paul-jo-dreyer/Atom/README.md

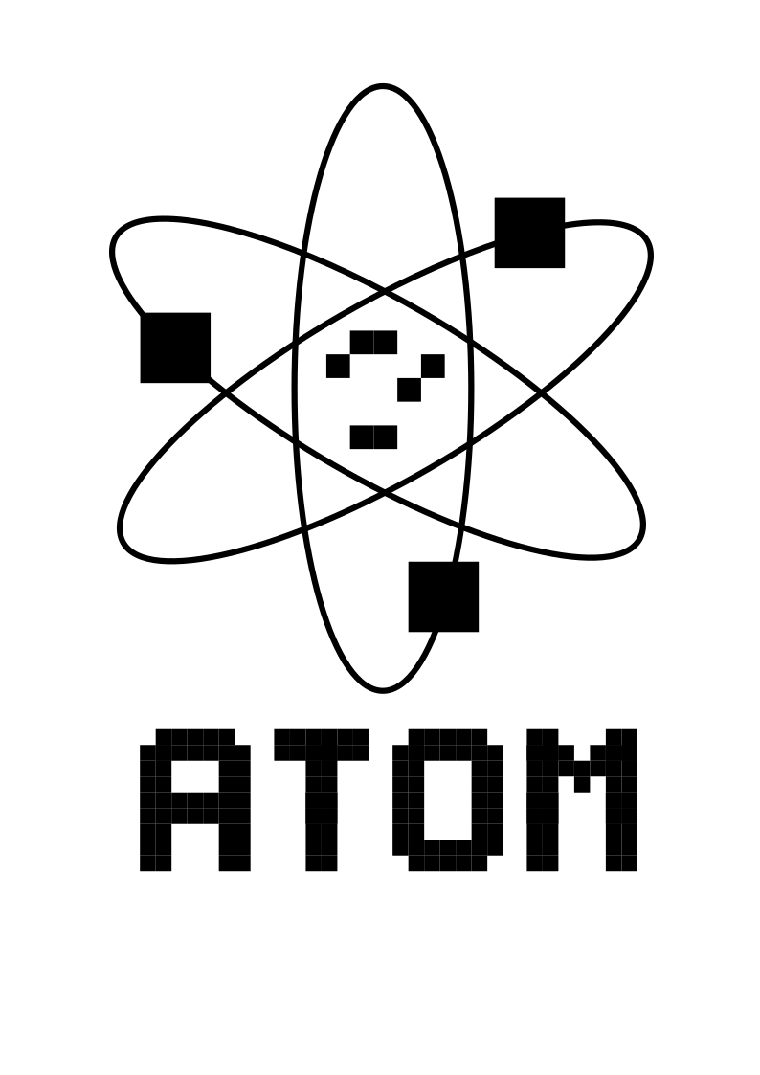
[picture p1: assets/ATOM.png]


# The Atom Project Overview

Atom is a micro modular robot designed as a test platform for studying swarm robotics, including multi-agent planning, control, and coordination. Up to 10 Atom robots can be in play at a given time, acting independently, or collaboratively. Paired with an **overwatch** application, state update information is streamed to each of the robots in a group broadcast, enabling rapid, low cost localization of each bot within the environment. 

## Communications

Each Atom is connected to a local Wifi network. 

## Localization

Localization of the system is handled by an overwatch system, which identifies Apriltags attached to the compute-chunk of each robot, and to the base station.

# Case Studies

## 1v1 Soccer
