paul-jo-dreyer/Atom/AtomSim/vehicle_dynamics/diff_drive/analysis/diff_drive.pdf

## diff drive dynamics: derivation and analysis

Atom project

April 26, 2026

Abstract

This document derives the planar dynamics of a two-wheeled differential-drive vehicle, start-ing from the rolling-without-slipping wheel constraints and ending at the analytic Jacobians used by the linearisation. It is the canonical reference for the C++ implementation in
bl bla blaaa ssss dynamics/diff drive/core/ and the numerical companion notebook in analysis/dynamics tour.ipynb.

## Contents

1 Setup and notation | 2
2 Wheel-contact constraints | 3
3 Kinematics: wheel speeds and body twist | 4
4 Dynamics: motor lag and the state ODE | 6

5 Linearisation about an operating point | 7
6 Verification | 9

## 1 Setup and notation

### 1.1 Frames

We work entirely in the plane. The world frame is inertial with axes (ˆxw, yŵ). The body frame is rigidly attached to the vehicle at the geometric centre of the wheel axle, with ˆxb pointing forward (the direction of travel when both wheels rotate equally) and ŷb pointing to the left:

xˆb =

cos θ
sin θ
, yˆb =
− sin θ
cos θ
. | (1)

### 1.2 Configuration and velocities

The configuration is
q = (px, py, θ) ∈ R

2 × S

1
, | (2)

where (px, py) is the world-frame position of the wheel-axle midpoint and θ is the heading. We use the body twist (v, ω) as the dynamical coordinates for translational and angular velocity:

v = ṗx cos θ + ṗy sin θ, | (3)
ω = ˙θ. | (4)

Once the no-side-slip constraint of §2 is imposed, this reduces to ( ṗx, pẏ) = v xˆb.

### 1.3 Geometric and actuator parameters

Track width W — distance between the left and right wheel contacts. Default 0.2 m.

Wheel radius rw — used only when converting between commanded wheel angular velocity ϕ˙ and rim velocity vw = rw ϕ˙

Motor time constant τ — first-order lag from commanded to realised body velocities. Default 0.05 s.

### 1.4 Wheel inputs

The control input is the pair of commanded wheel rim velocities u = (vL, vR), with vL = rw ϕ˙
L
and similarly for the right wheel. We use vL, vR rather than ϕ˙

L, ϕṘ throughout because the wheel radius is absorbed at the controller boundary and never appears in the body dynamics. The Control<Scalar> type in types.hpp stores exactly this pair.

## 2 Wheel-contact constraints

The vehicle has two wheels, each treated as an ideal rigid disk rolling without slipping on a planar ground. Each contact point yields two scalar constraints — one along the rolling direction and one perpendicular to it. Below we derive both, show that the lateral pair degenerates into a single body-level constraint, and prove that this constraint is non-holonomic.

### 2.1 Wheel positions and contact velocities

The left wheel sits a distance W/2 along ŷb from the body origin; the right wheel sits the same distance along −yˆb:

rL =

px −

1
2W sin θ
py +

1
2W cos θ
, | rR =
px +

1
2W sin θ
py −

1
2W cos θ
. | (5)

Differentiating in time,

r˙L =

pẋ −

1

2W ˙θ cos θ
pẏ −

1

2W ˙θ sin θ

, | rṘ =
pẋ +

1

2W ˙θ cos θ

pẏ +

1

2W ˙θ sin θ

. | (6)

### 2.2 Lateral constraint (no side slip)

Each wheel cannot move along its axle. Both axles are aligned with ŷb, so for each wheel the constraint is ṙw · yˆb = 0:

r˙L · yˆb = −pẋ sin θ +

1

2W ˙θ cos θ sin θ + ṗy cos θ −
1

2W ˙θ sin θ cos θ

= −pẋ sin θ + ṗy cos θ. | | (7)

The ˙θ-dependent cross terms cancel because the wheel offset is itself along ŷb, so the spin-induced contact velocity is along ˆxb, not ŷb. The right wheel gives the same expression. Both lateral constraints therefore collapse into a single body-level Pfaffian constraint:

| − sin θ pẋ + cos θ pẏ = 0. | (8)

### 2.3 Longitudinal constraint (pure rolling)

The forward velocity of each wheel contact equals its rim velocity:

r˙L · xˆb = vL, | rṘ · xˆb = vR. | (9)

Expanding,

vL = ṗx cos θ + ṗy sin θ −

1

| 2W ˙θ = v −
| 1
| 2W ω, | (10)

vR = ṗx cos θ + ṗy sin θ +

1

| 2W ˙θ = v +
| 1
| 2W ω. | (11)

Solving for the body twist,

v =

1/2(vL + vR), | ω =
| vR − vL
| W
| . | (12)

This is the map used at the top of DiffDriveDynamics::continuous in core/dynamics.hpp.

### 2.4 Pfaffian form

Stacking the three constraints,

− sin θ cos θ 0
cos θ sin θ −

1
2W
cos θ sin θ +

1
2W
| | {z | }
| A(q)

pẋ
pẏ
˙θ
- =

0
vL
vR
- . | (13)

Row 1 is homogeneous in ˙q — no actuator drives it. This is the non-holonomic part. Rows 2–3 are inhomogeneous, driven by the wheel commands.

### 2.5 The constraint is non-holonomic

A Pfaffian constraint a(q) · q˙ = 0 is integrable to a function h(q) = const if and only if the dual distribution ∆ = ker a(q) is involutive (Frobenius theorem). For (8),

∆ = span{X1, X2}, X1 =

cos θ
sin θ
0
- , X2 =

0
0
1
- , | (14)

where X1 generates pure forward motion and X2 generates pure rotation in place. The Lie bracket is
[X1, X2] = ∂X1
∂q X2 −

∂X2
∂q X1 =

− sin θ
cos θ
0
- − 0. | (15)

This vector is precisely the body-lateral direction (8) forbids, so [X1, X2] ∈/ ∆. The distribution is therefore non-involutive, (8) is non-integrable, and the system is non-holonomic. □

Remark (Chow’s theorem and parking). The set {X1, X2, [X1, X2]} spans R

3 at every q. By
Chow’s theorem the system is locally controllable: any configuration (px, py, θ) can be reached by combining forward motion and rotation, even though the vehicle has only two control inputs and cannot translate sideways instantaneously. Parallel parking is the everyday demonstration of this fact.

### 2.6 Consistency with the implementation

The state ODE in dynamics.hpp is written directly in body coordinates,

pẋ = v cos θ, | pẏ = v sin θ, | (16)

which substituted into (8) gives −v sin θ cos θ + v sin θ cos θ = 0 identically. The constraint is built into the parameterisation; the simulator does not need projection or Lagrange multipliers to enforce it at runtime. The numerical verification of this identity over a long rollout will live in analysis/dynamics tour.ipynb (a future “Test 5: constraint satisfaction” cell).

## 3 Kinematics: wheel speeds and body twist

The constraints in §2 relate wheel rim velocities (vL, vR) to body twist (v, ω) via (12). This section unpacks the consequences of that map: how to convert between actuator space and body space, the geometric picture, and the special operating modes that come up later.

### 3.1 Forward and inverse maps

The forward map (wheel commands → body twist), restated from (12),

v =

1/2(vL + vR), ω =

vR − vL
W
. | (17)

The inverse map (desired body twist → wheel commands) follows immediately from the rolling constraints in §2:
vL = v −

1
2W ω, vR = v +

1
2W ω. | (18)

Both maps are linear and invertible, so the kinematic state of the differential drive is captured equally well in either parameterisation. Internally the dynamics core in §4 carries (v, ω) as state and treats (vL, vR) as the boundary input, because the body twist is what couples to the motor lag and to Box2D.

### 3.2 Instantaneous centre of rotation

For any non-zero ω the body’s instantaneous motion is a rotation about a point fixed in the world frame at signed distance R along ŷb, where

R =

v
ω

=

W
2

·

vL + vR
vR − vL
. | (19)

This is the instantaneous centre of rotation (ICR). R is the signed turn radius: positive when turning left (CCW), negative when turning right.

### 3.3 Special operating modes

Pure forward. vL = vR =⇒ ω = 0, v = vL = vR. Straight-line motion; ICR at infinity.

Pure rotation. vL = −vR =⇒ v = 0, ω = 2vR/W. The vehicle spins about the body origin; ICR coincident with the axle midpoint.

One wheel locked. vL = 0 =⇒ v = vR/2, ω = vR/W, R = W/2. The vehicle pivots about the locked wheel; ICR at the locked wheel’s contact point.

These three modes form a useful test set — each isolates one component of (17) from the others, and Test 2 and Test 3 of dynamics tour.ipynb exercise the first two directly (§6).

### 3.4 The kinematic unicycle interpretation

Once the no-slip constraint (8) is imposed, the planar motion of the vehicle is entirely described by a unicycle on (px, py, θ) driven by the body twist (v, ω):

pẋ = v cos θ, | (20)
pẏ = v sin θ, | (21)
˙θ = ω. | (22)

The differential-drive structure shows up only in (i) how (v, ω) are produced by the wheels — equation (17) above — and (ii) the motor lag in §4 that separates commanded from realised body twist. Many planning algorithms operate at the unicycle level and only invert through (18) at the lowest control layer; we keep both layers explicit here because the motor lag couples them at the dynamics level.

## 4 Dynamics: motor lag and the state ODE

The kinematic map of §3 treats wheel commands as instantaneously producing the desired body twist. Real motors have inertia, controller dynamics, and current limits; their realised speed lags the command. We fold all of this into a single first-order lag on the body velocities.

### 4.1 Commanded body twist

The wheel command pair u = (vL, vR) produces a commanded body twist via the forward kinematic map (17):

vcmd =

1/2(vL + vR), ωcmd =

vR − vL
W
. | (23)

“Commanded” to distinguish from the realised body velocities (v, ω) that appear in the state.

### 4.2 Motor lag

The realised body velocities track the commanded values through a first-order lag with time constant τ :

v˙ =

1
τ
vcmd − v
, | (24)

ω˙ =

1
τ
ωcmd − ω
. | (25)

The same time constant is used for both channels. We could carry separate τ

v and τ

ω
if a motor
identification campaign warranted it, but in practice the difference is absorbed into the per-episode domain randomisation in training/.
Remark (Why first-order, not second-order?). A second-order lag would track an additional state per channel (acceleration), capturing the motor’s torque dynamics more faithfully. For the wheel masses and drive sizing we expect, the second-order modes are well above the policy’s control bandwidth and a first-order fit is adequate. The model can be promoted to second-order later without disturbing anything outside this section.

### 4.3 Full state ODE

Stack the position, heading, and body twist into a single state vector x ∈ R

5
:

x =

px | py | θ v ω⊤
. | (26)

Combining the unicycle kinematics (22) with the motor lag (24)–(25) and substituting (23):

x˙ = f(x, u) =

v cos θ
v sin θ
ω
1
τ
1/2(vL + vR) − v

1
τ
vR − vL
W

− ω

. | (27)

This is the equation DiffDriveDynamics::continuous in core/dynamics.hpp implements verba-tim. The integrator (rk4 step in core/integrators.hpp) treats u as zero-order-hold over a step of length ∆t and advances x accordingly.

### 4.4 Why 5-D, not 7-D?

There are three reasonable parameterisations:

3-D kinematic. State (px, py, θ), input (v, ω). No actuator dynamics — fine for kinematic plan-ners but useless for tracking control.

5-D body-lag. State (px, py, θ, v, ω), input (vL, vR). Single first-order lag at the body level. This document.

7-D wheel-lag. State (px, py, θ, ϕ˙

L, ϕṘ, . . .), input (vL, vR). Per-wheel lag, body twist computed downstream.

We chose the middle option: it captures the dominant transient (motor lag) without paying for two redundant per-wheel states, and it keeps the embedded MPC problem small enough that linearised solvers like TinyMPC stay in their sweet spot. If a future task demonstrates per-wheel lag matters — e.g., uneven loading or one motor saturating before the other — the model expands to 7-D, but evidence-driven, not preemptively.

### 4.5 Slip

The model assumes pure rolling. The kinematic map (17) carries no slip term, and the motor lag operates on the resulting body velocities directly. Domain randomisation on W, τ , and the per-wheel gain absorbs much of what slip would contribute in practice. If a deployed policy starts exploiting non-physical kinematic behaviour — e.g., turning faster than ωcmd permits — a velocity-dependent slip term such as

ωachieved = ωcmd (1 − α |v|) | (28)

can be folded into (23), but only as a corrective response to observed exploit, not as an a-priori complication.

## 5 Linearisation about an operating point

For controller design (LQR, MPC) and stability analysis we need the Jacobians A = ∂f /∂x and B = ∂f /∂u evaluated at an operating point (x

⋆

, u⋆
). They are sparse and analytic, with no allocation and only a handful of elementary functions — exactly what an embedded linear MPC solver wants.

### 5.1 State Jacobian A

Differentiating (27) entry-by-entry with respect to x,

A(x) = ∂f
∂x

=

0 0 −v sin θ | cos θ | 0
0 0 | v cos θ | sin θ | 0
0 0 | 0 | 0 | 1
0 0 | 0 | −1/τ | 0
0 0 | 0 | 0 | −1/τ

. | (29)

Structure worth noticing:

Position rows. Rows 1–2 are exactly the kinematic-unicycle rows: position rates depend on (v, θ) but on neither position nor ω.

Heading row. Row 3 is trivial — ˙θ depends only on ω.

Velocity rows. Rows 4–5 are pure first-order decay, independent of anything else in the state. The motor lag does not couple to position or heading.

Operating-point dependence. Only column 3 (the θ-derivatives) and column 4 (the v-derivatives in rows 1–2) carry trigonometric terms. Everything else is a constant.

### 5.2 Control Jacobian B

The control affects only the velocity rows of f, through the commanded twist (23). Differentiating with respect to u = (vL, vR):

B =

∂f
∂u =

0 | 0
0 | 0
0 | 0
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
. | (30)

B is constant: it depends on neither x nor u. The signs of the bottom row encode left-handed-versus-right-handed yaw: a positive vR alone produces positive ω (CCW yaw); a positive vL alone produces negative ω (CW). Row 4 is symmetric in the two wheels because the body forward velocity is their average.

### 5.3 Linear rollout error

Near the operating point the nonlinear flow agrees with the linear approximation up to second order. By Taylor’s theorem, for fixed u

⋆
,

f(x

⋆ + δx, u⋆
) − f(x

⋆

, u⋆
) − A(x

⋆
) δx = O
∥δx∥

2
. | (31)

Plotting the residual norm against ∥δx∥ on log–log axes therefore gives a slope of exactly 2 when the analytic A in (29) is correct. This is the strongest single test of the linearisation, and the one Test 4 of dynamics tour.ipynb runs (see §6).

### 5.4 Verification routes

We treat (29)–(30) as the definitive analytic form, then verify them by three independent means:

1. Finite differences in C++. Compute centred-difference estimates of A and B at random operating points and compare entry-wise. Cheap; catches sign flips, factor-of-two errors, and
missing entries. To be added as a doctest case in core/tests/.
2. Forward-mode autodiff in C++. Instantiate DiffDriveDynamics<Eigen::AutoDiffScalar<Eigen::Matrix<double,5,1>>> and read A off the autodiff result directly; compare to the analytic form. To be added once
an autodiff dependency is wired in.
3. Symbolic re-derivation in Julia. analysis/jacobian verify.jl (planned) re-derives (29)–(30) symbolically with Symbolics.jl and compares numerically at random operating points. This catches errors in the LaTeX itself, not just in the C++.

The slope-2 numerical test in the notebook (Test 4) sits across all three routes: it verifies the C++ implementation and the analytic form simultaneously, without referring to any third source. As long as that test passes, A is correct in the dynamic — “does the simulation flow agree with the linear flow near the operating point?” — sense, even if some hand-derived entries happened to be wrong they would have to be wrong in compensating ways. It is the single test most worth running on every CI build.

## 6 Verification

The C++ in core/ and the equations in this document must stay in agreement. We pin them together with two layers of tests: doctest unit tests in core/tests/ that run on every CI build, and the Jupyter notebook analysis/dynamics tour.ipynb that exercises the same code from Python with plots and looser numerical tolerances. This section maps each result derived above to the test that verifies it.

### 6.1 Test crosswalk

Notebook test | Verifies | Equation
1. Motor-lag step response | First-order lag on ˙v | (24)
2. Pure rotation | No side slip (v = 0, px = py = 0) | (8)
| Yaw rate from differential commands | (17)
3. Constant arc | Steady-state turn radius R = vss/ωss | (19)
4. Linearisation residual | Analytic A matches the nonlinear flow to first order | (29), (31)

The core/tests/ doctest binary runs three lower-level checks: state derivative at the origin under symmetric control, single-step RK4 sanity, and finiteness of A and B. It is the build-time canary; the notebook is the analyst-facing companion that produces plots.

### 6.2 Tests still to add

Two checks are derived in this document but not yet wired into either test layer:

1. Constraint satisfaction along long rollouts. (8) is identically satisfied by the parameterisation (27), so this is essentially a regression test against the position equations being edited. Future Test 5 of the notebook: roll out for several seconds under a varying control sequence and assert
| − sin θ(t) ṗx(t) + cos θ(t) ṗy(t)

< 10⁻¹²

at every time step.

2. Finite-difference Jacobian comparison in C++. §5 derives A and B analytically; the doctest binary should compare them to centred-difference estimates at randomly sampled operating points. This is the cheapest of the three verification routes from §5 and the highest-value to add first.

When either of these is added, this section’s table grows by one row and the corresponding bullet here is removed.

### 6.3 Editing discipline

The chain of authority across the project is:

LaTeX (here) −→ C++ (core/) −→ Python (bindings/, notebook).

If the LaTeX changes, the C++ must change to match before the doctest binary is re-run. If the C++ changes without the LaTeX, the doctest will likely still pass — but the document will be wrong, and the next person to read it will derive the wrong control law from the wrong equation. The reviewer’s job on any core/ pull request is to confirm the LaTeX is updated in lockstep.
