paul-jo-dreyer/Atom/assets/chunk_pannel.jpg

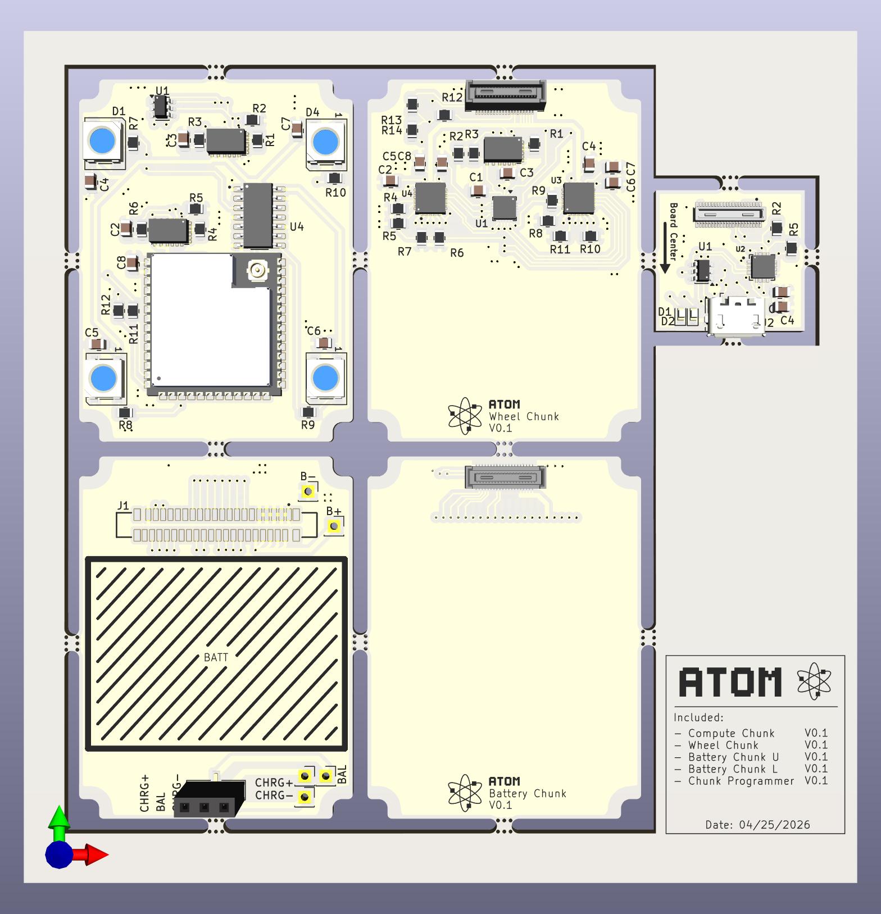
assets/chunk_pannel.jpg
