paul-jo-dreyer/Atom/assets/chunk_pannel_.png

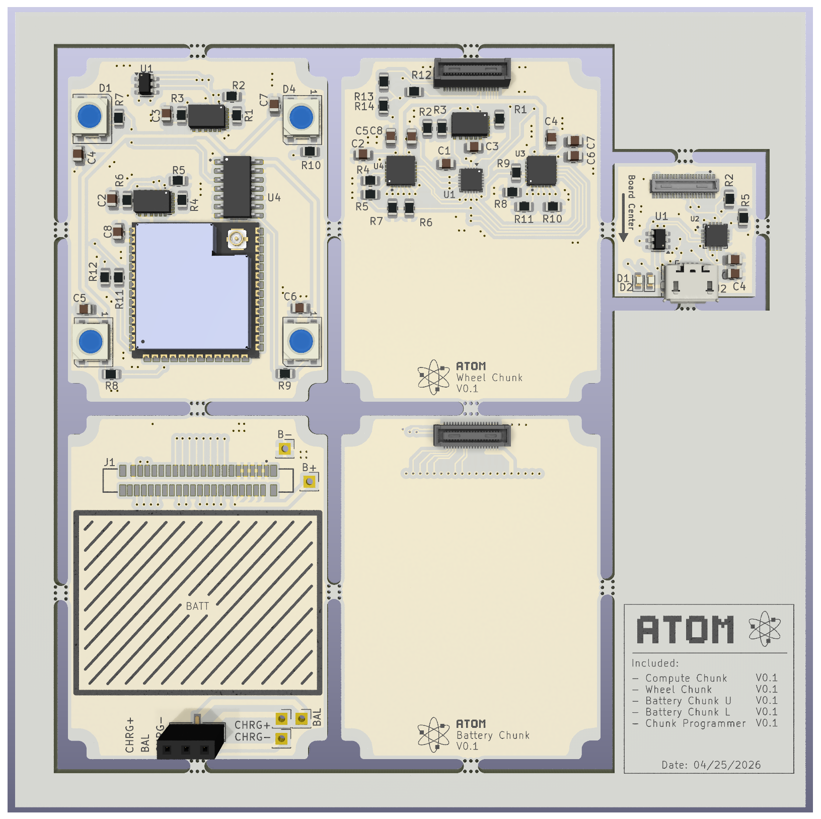
assets/chunk_pannel_.png
