paul-jo-dreyer/Atom/AtomGym/research/ball_alignment/baseline.png

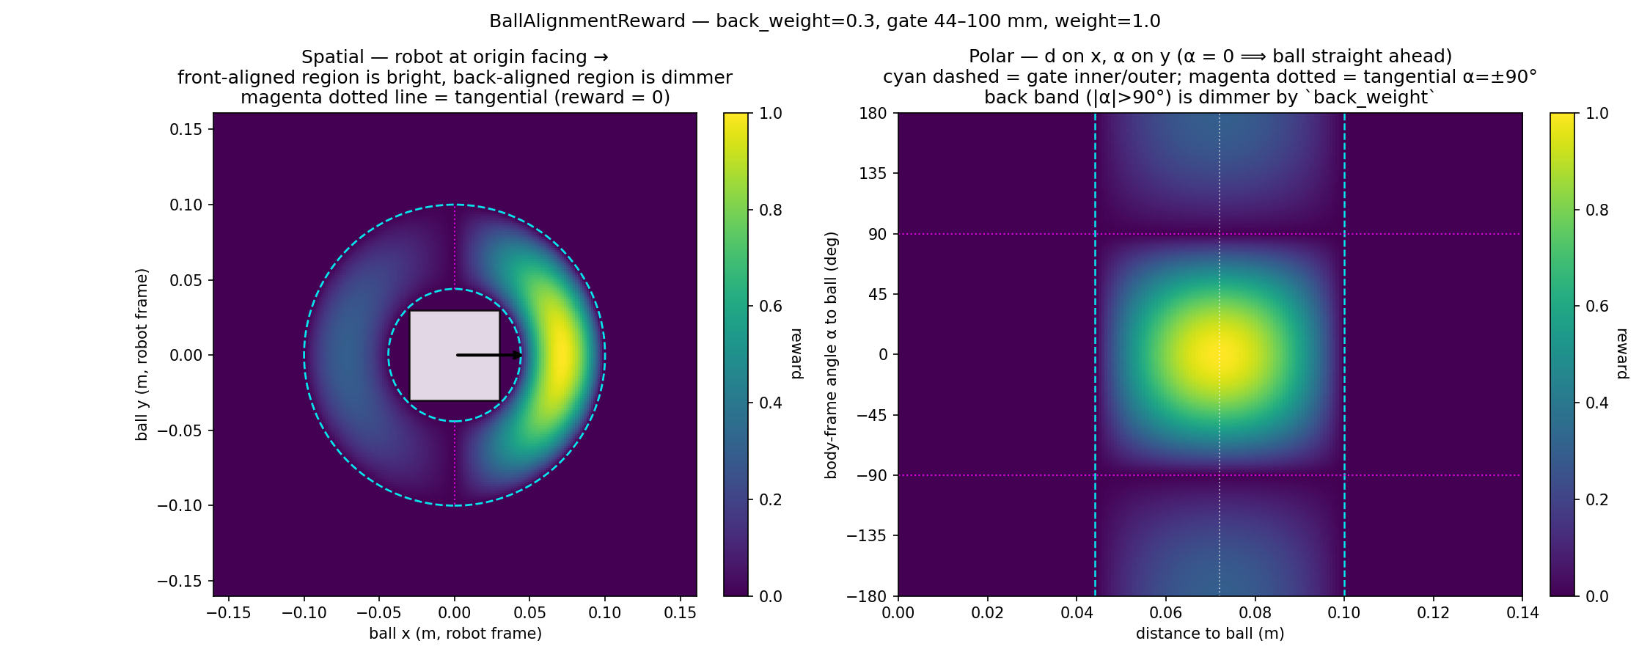
AtomGym/research/ball_alignment/baseline.png
