paul-jo-dreyer/Atom/AtomGym/research/goalie_box/doc_animation.gif

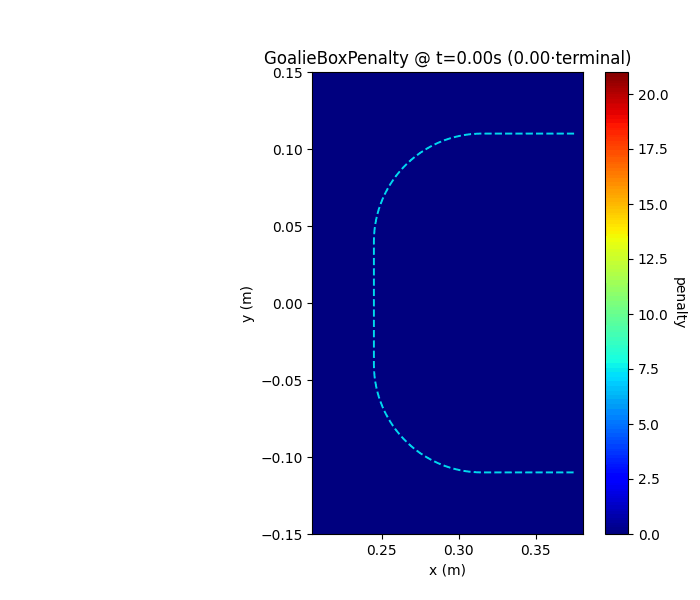
AtomGym/research/goalie_box/doc_animation.gif
