paul-jo-dreyer/Atom/AtomGym/research/goalie_box/doc_floor_0.png

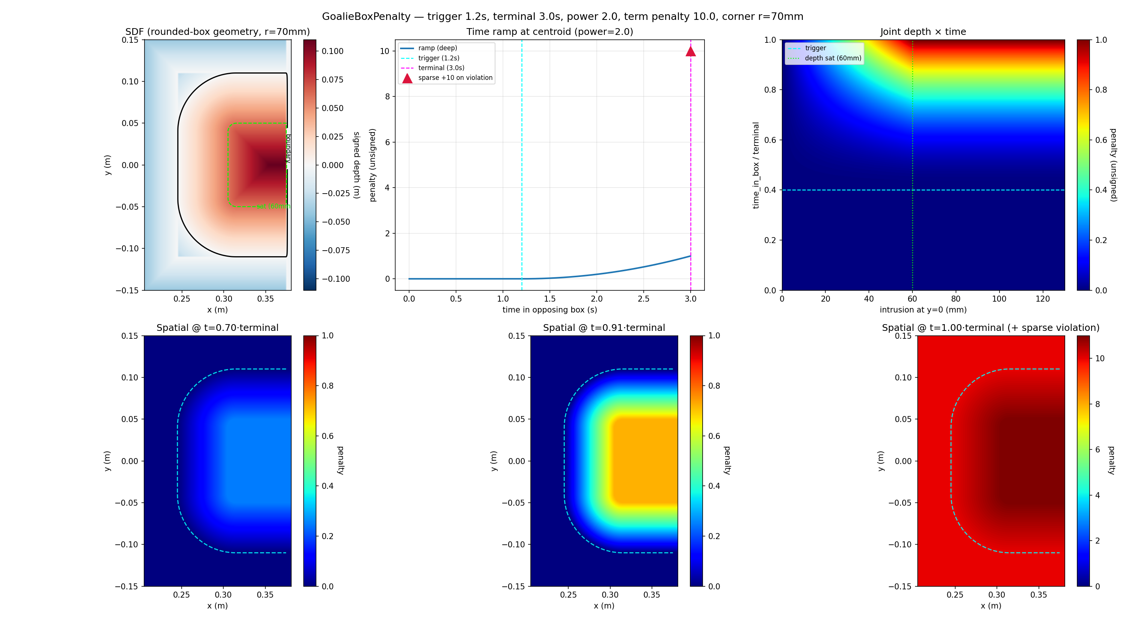
AtomGym/research/goalie_box/doc_floor_0.png
