paul-jo-dreyer/Atom/AtomGym/research/goalie_box/goalie_box_heatmap.png

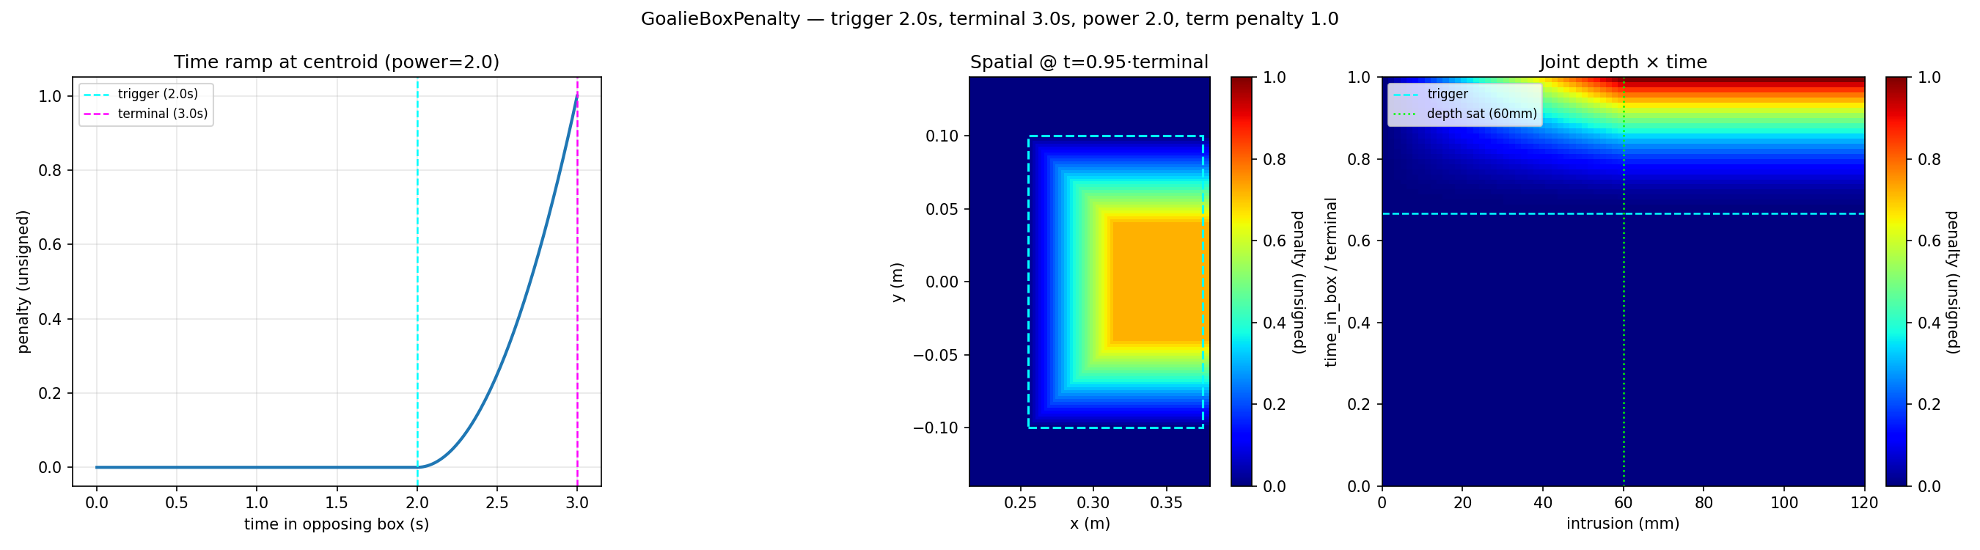
AtomGym/research/goalie_box/goalie_box_heatmap.png
