paul-jo-dreyer/Atom/AtomSim/sim/python/demo_trajectory.png

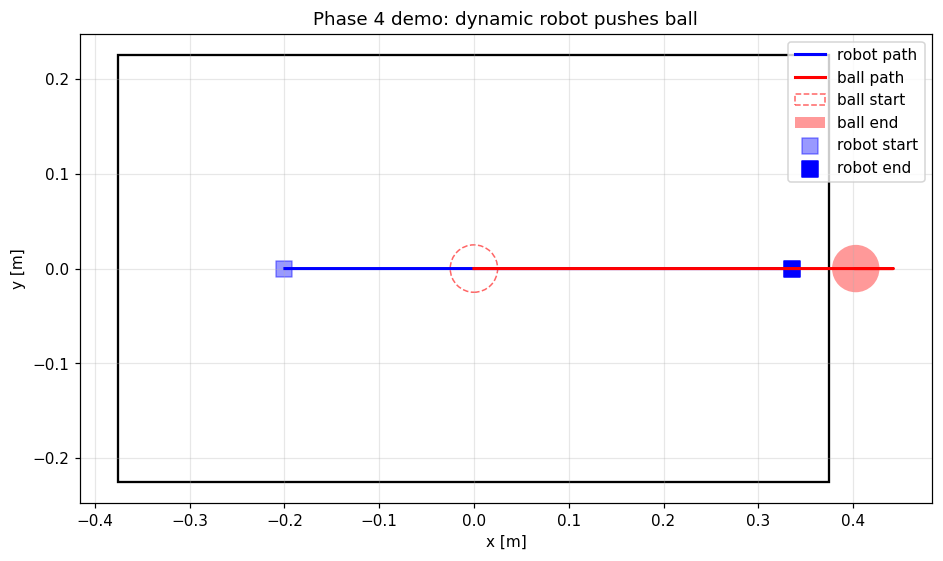
AtomSim/sim/python/demo_trajectory.png
