paul-jo-dreyer/Atom/static_field_heatmap.png

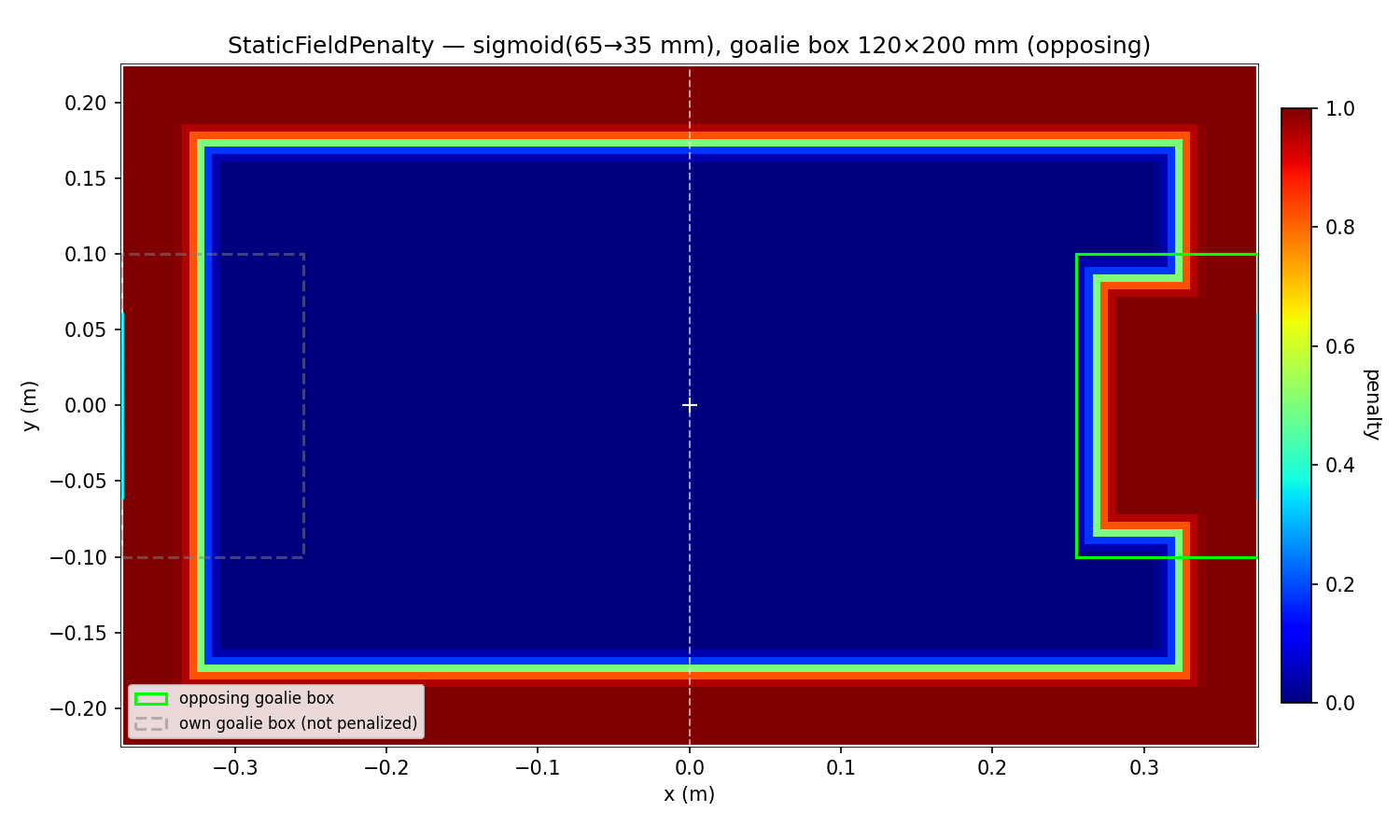
static_field_heatmap.png
