paul-jo-dreyer/Atom/AtomPCB/chunks/Battery_chunk/lower_board/battery_chunk_lower_board.stl

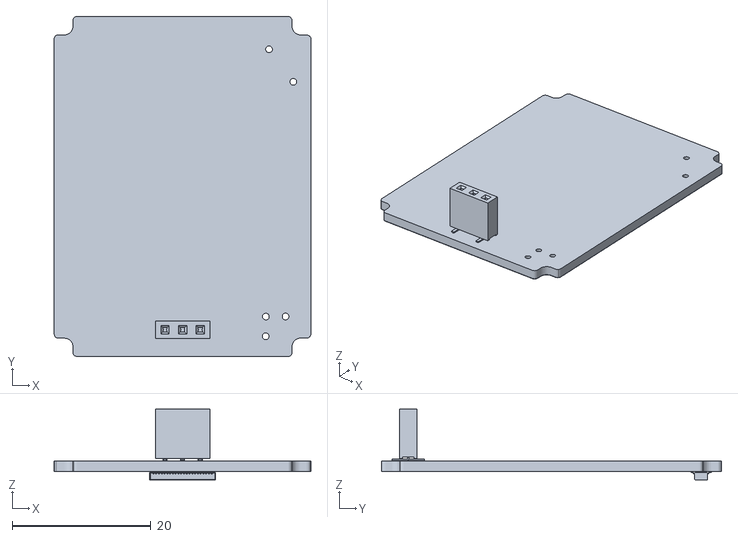
[picture p11: CAD file, 2026-04-27]
AtomPCB/chunks/Battery_chunk/lower_board/battery_chunk_lower_board.stl
37.0 x 49.0 x 10.2
