paul-jo-dreyer/Atom/AtomPCB/chunks/Battery_chunk/upper_board/Battery_chunk_upper_board.stl

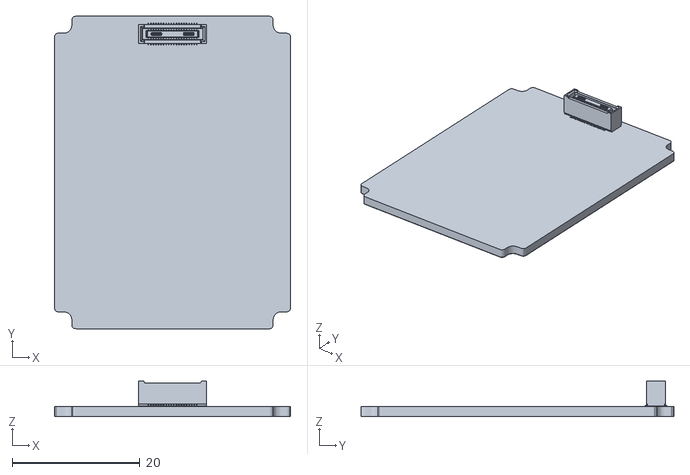
[picture p12: CAD file, 2026-04-27]
AtomPCB/chunks/Battery_chunk/upper_board/Battery_chunk_upper_board.stl
37.0 x 49.0 x 5.57
