paul-jo-dreyer/Atom/AtomPCB/footprints/BF100_20_A_D_0_0640_L_C/KiCADv6/BF100-20-A-D-0-0640-L-C.STEP

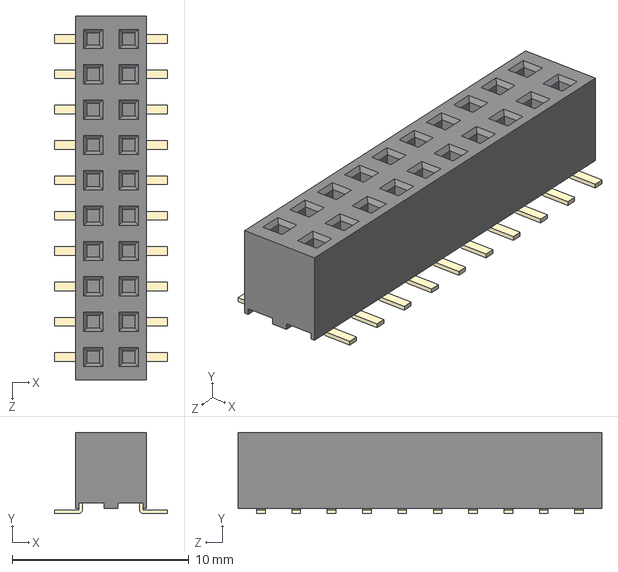
[picture p13: CAD file, 2026-04-27]
AtomPCB/footprints/BF100_20_A_D_0_0640_L_C/KiCADv6/BF100-20-A-D-0-0640-L-C.STEP
6.40 x 4.60 x 20.6 mm
Body^BF100-xxxx_20
Pin^BF100-xxxx x 10
