paul-jo-dreyer/Atom/AtomPCB/footprints/CP2102N_A02_GQFN20R/CP2102N-A02-GQFN20R.step

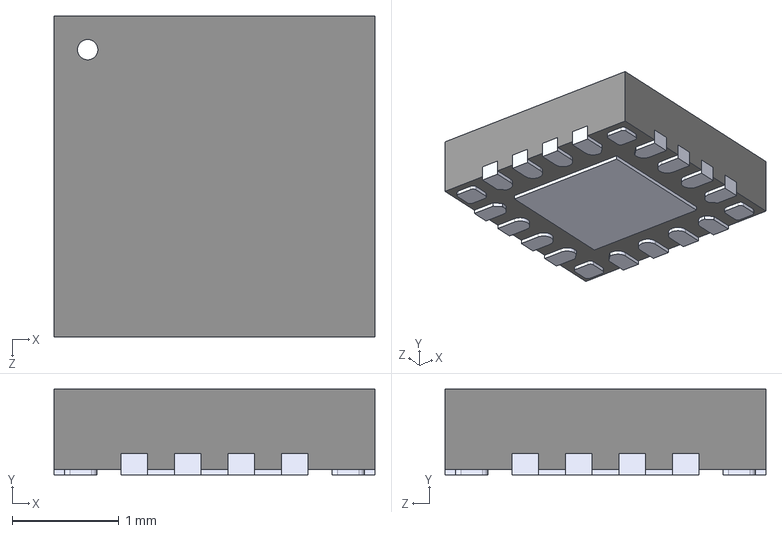
[picture p14: CAD file, 2026-04-27]
AtomPCB/footprints/CP2102N_A02_GQFN20R/CP2102N-A02-GQFN20R.step
3.00 x 0.8 x 3.00 mm
