paul-jo-dreyer/Atom/AtomPCB/footprints/DF40C_40DP_0_4V_51_/DF40C-40DP-0.4V_51_.step

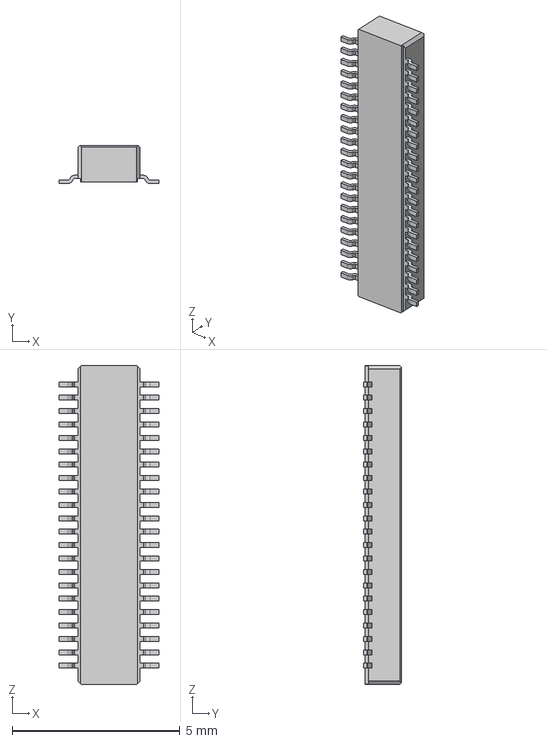
[picture p15: CAD file, 2026-04-20]
AtomPCB/footprints/DF40C_40DP_0_4V_51_/DF40C-40DP-0.4V_51_.step
2.97 x 1.14 x 9.52 mm
