paul-jo-dreyer/Atom/AtomPCB/footprints/DF40HC_4_0__40DS_0_4V_70_/DF40HC(4.0)-40DS-0.4V(70).STEP

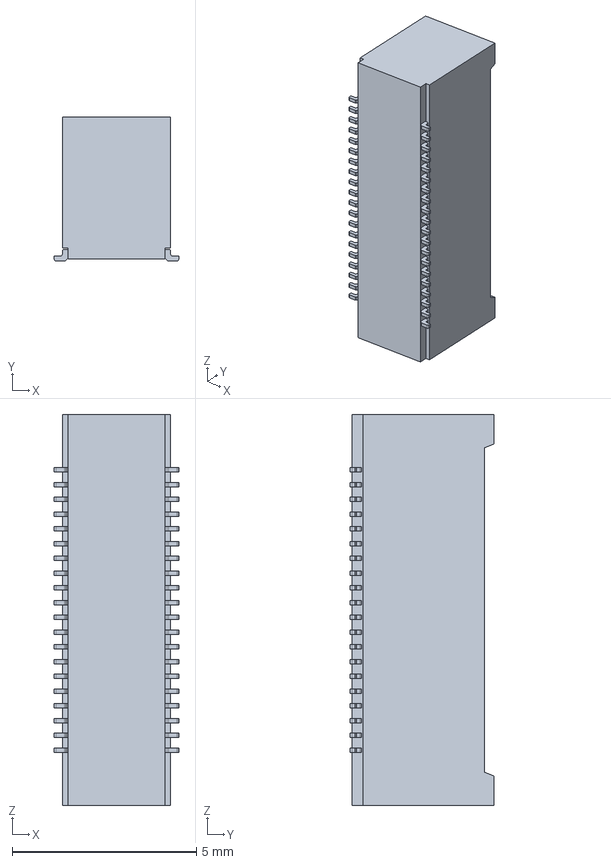
[picture p16: CAD file, 2026-04-27]
AtomPCB/footprints/DF40HC_4_0__40DS_0_4V_70_/DF40HC(4.0)-40DS-0.4V(70).STEP
3.38 x 3.90 x 10.6 mm
