paul-jo-dreyer/Atom/AtomPCB/footprints/DRV8834RGER/DRV8834RGER.step

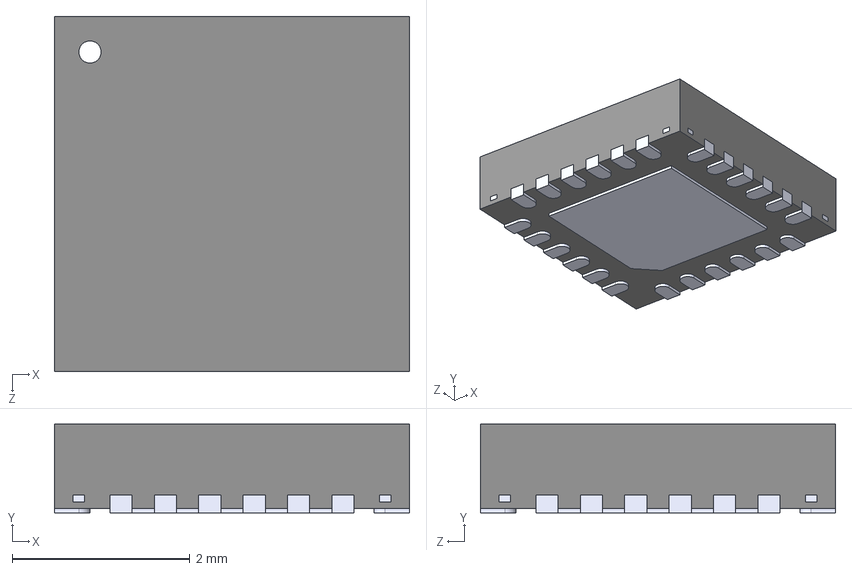
[picture p17: CAD file, 2026-04-15]
AtomPCB/footprints/DRV8834RGER/DRV8834RGER.step
4.00 x 1.00 x 4.00 mm
