paul-jo-dreyer/Atom/AtomPCB/footprints/ESP32_S3_WROOM_1U_N8R8/ESP32-S3-WROOM-1U-N8R8.step

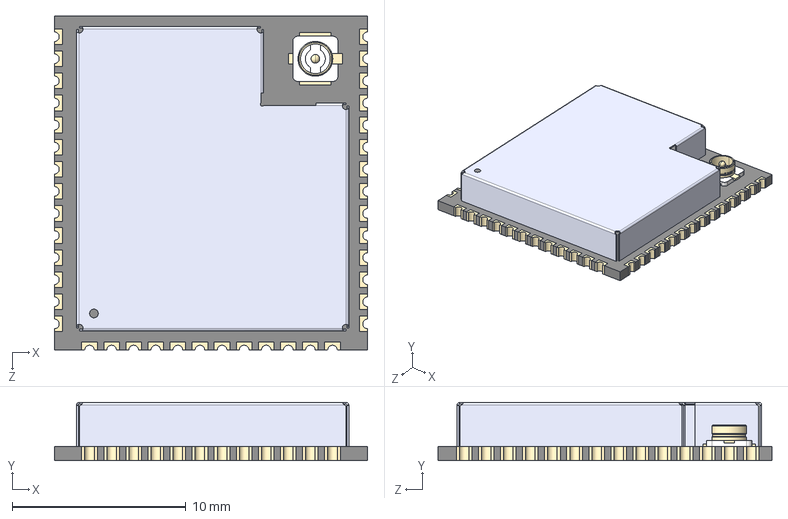
[picture p18: CAD file, 2026-04-20]
AtomPCB/footprints/ESP32_S3_WROOM_1U_N8R8/ESP32-S3-WROOM-1U-N8R8.step
18.0 x 3.35 x 19.2 mm
