paul-jo-dreyer/Atom/AtomPCB/footprints/FFC2A32_40_T/FFC2A32-40-T.step

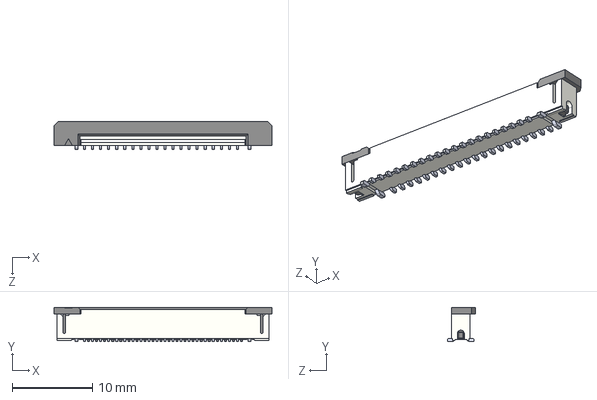
[picture p19: CAD file, 2026-04-27]
AtomPCB/footprints/FFC2A32_40_T/FFC2A32-40-T.step
27.1 x 4.25 x 3.48 mm
FFC2A32-xxxx_40
pin x 40
