paul-jo-dreyer/Atom/AtomPCB/footprints/LIB_DF40HC_4.0_-40DS-0.4V_70_/DF40HC_4.0_-40DS-0.4V_70_/3D/DF40HC_4.0_-40DS-0.4V_70_.stp

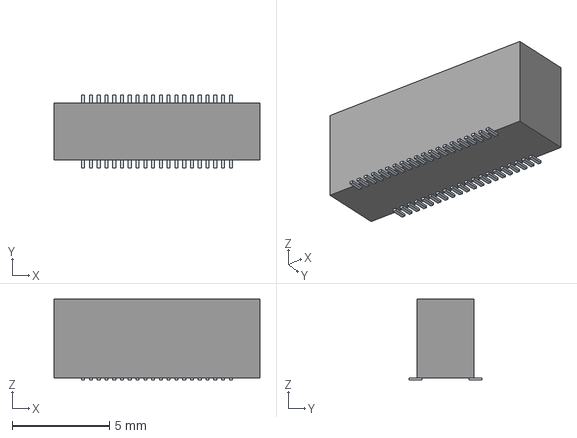
[picture p20: CAD file, 2026-04-15]
AtomPCB/footprints/LIB_DF40HC_4.0_-40DS-0.4V_70_/DF40HC_4.0_-40DS-0.4V_70_/3D/DF40HC_4.0_-40DS-0.4V_70_.stp
10.6 x 3.74 x 4.15 mm
Pins
