paul-jo-dreyer/Atom/AtomPCB/footprints/MPM3610AGQV-P/MPM3610AGQV-P.step

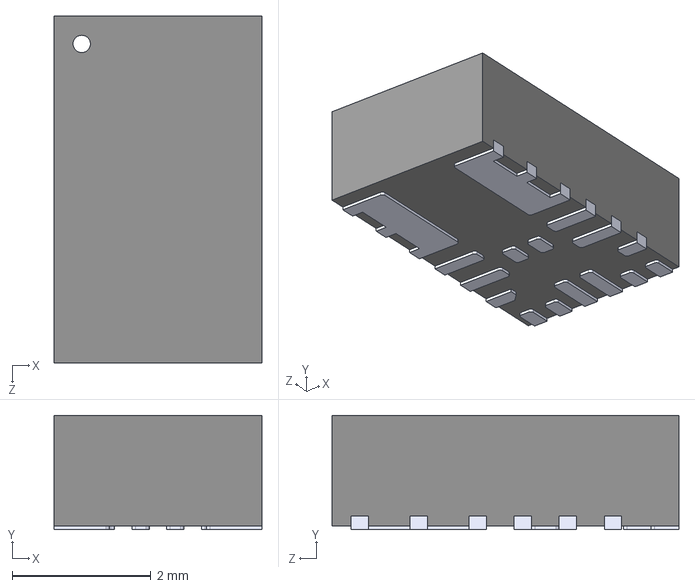
[picture p21: CAD file, 2026-04-15]
AtomPCB/footprints/MPM3610AGQV-P/MPM3610AGQV-P.step
3.00 x 1.65 x 5.00 mm
