paul-jo-dreyer/Atom/AtomPCB/footprints/SN74HCT125DR/SN74HCT125DR.step

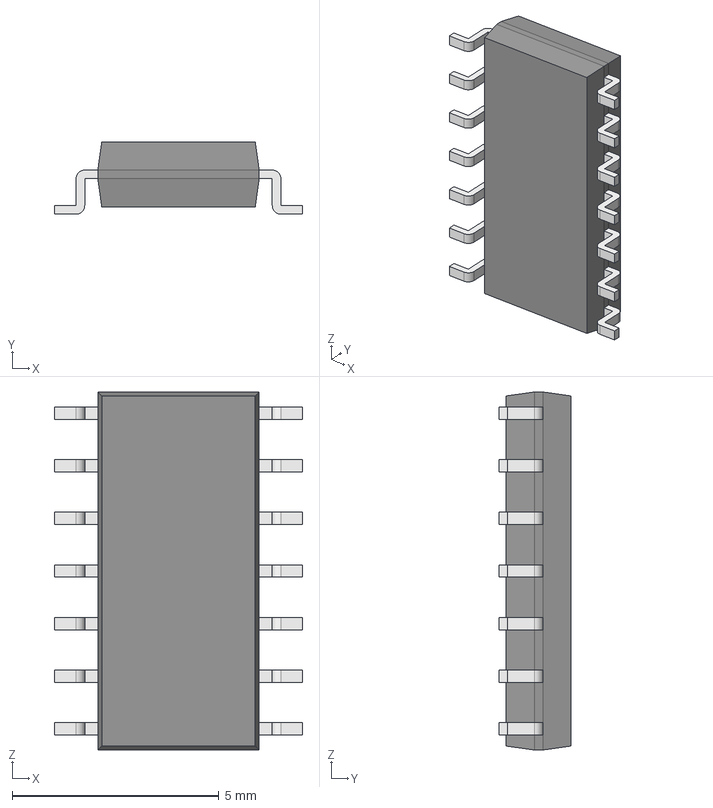
[picture p22: CAD file, 2026-04-20]
AtomPCB/footprints/SN74HCT125DR/SN74HCT125DR.step
6.00 x 1.75 x 8.65 mm
Body001 (Mirror #1) x 7
XY-plane x 12
X-axis x 12
