paul-jo-dreyer/Atom/(list of files, cad)

Other CAD files:
AtomPCB/footprints/LIB_DF40HC_4.0_-40DS-0.4V_70_/DF40HC_4.0_-40DS-0.4V_70_/Allegro/df40hc4040ds04v70.psm
AtomPCB/footprints/LIB_DF40HC_4.0_-40DS-0.4V_70_/DF40HC_4.0_-40DS-0.4V_70_/DEHDL/df40hc_4.0__40ds_0.4v_70_/chips/chips.prt
