paul-jo-dreyer/Atom/(list of files, drawings)

Other design files:
AtomPCB/footprints/LIB_DF40HC_4.0_-40DS-0.4V_70_/DF40HC_4.0_-40DS-0.4V_70_/Altium/DF40HC4040DS04V70.PcbLib
AtomPCB/footprints/LIB_DF40HC_4.0_-40DS-0.4V_70_/DF40HC_4.0_-40DS-0.4V_70_/Altium/DF40HC_4.0_-40DS-0.4V_70_.SchLib
