paul-jo-dreyer/Atom/AtomPCB/chunks/Wheel_chunk/Wheel_chunk.kicad_pcb

## KiCad design AtomPCB/chunks/Wheel_chunk/Wheel_chunk.kicad_pcb (2026-05-16)

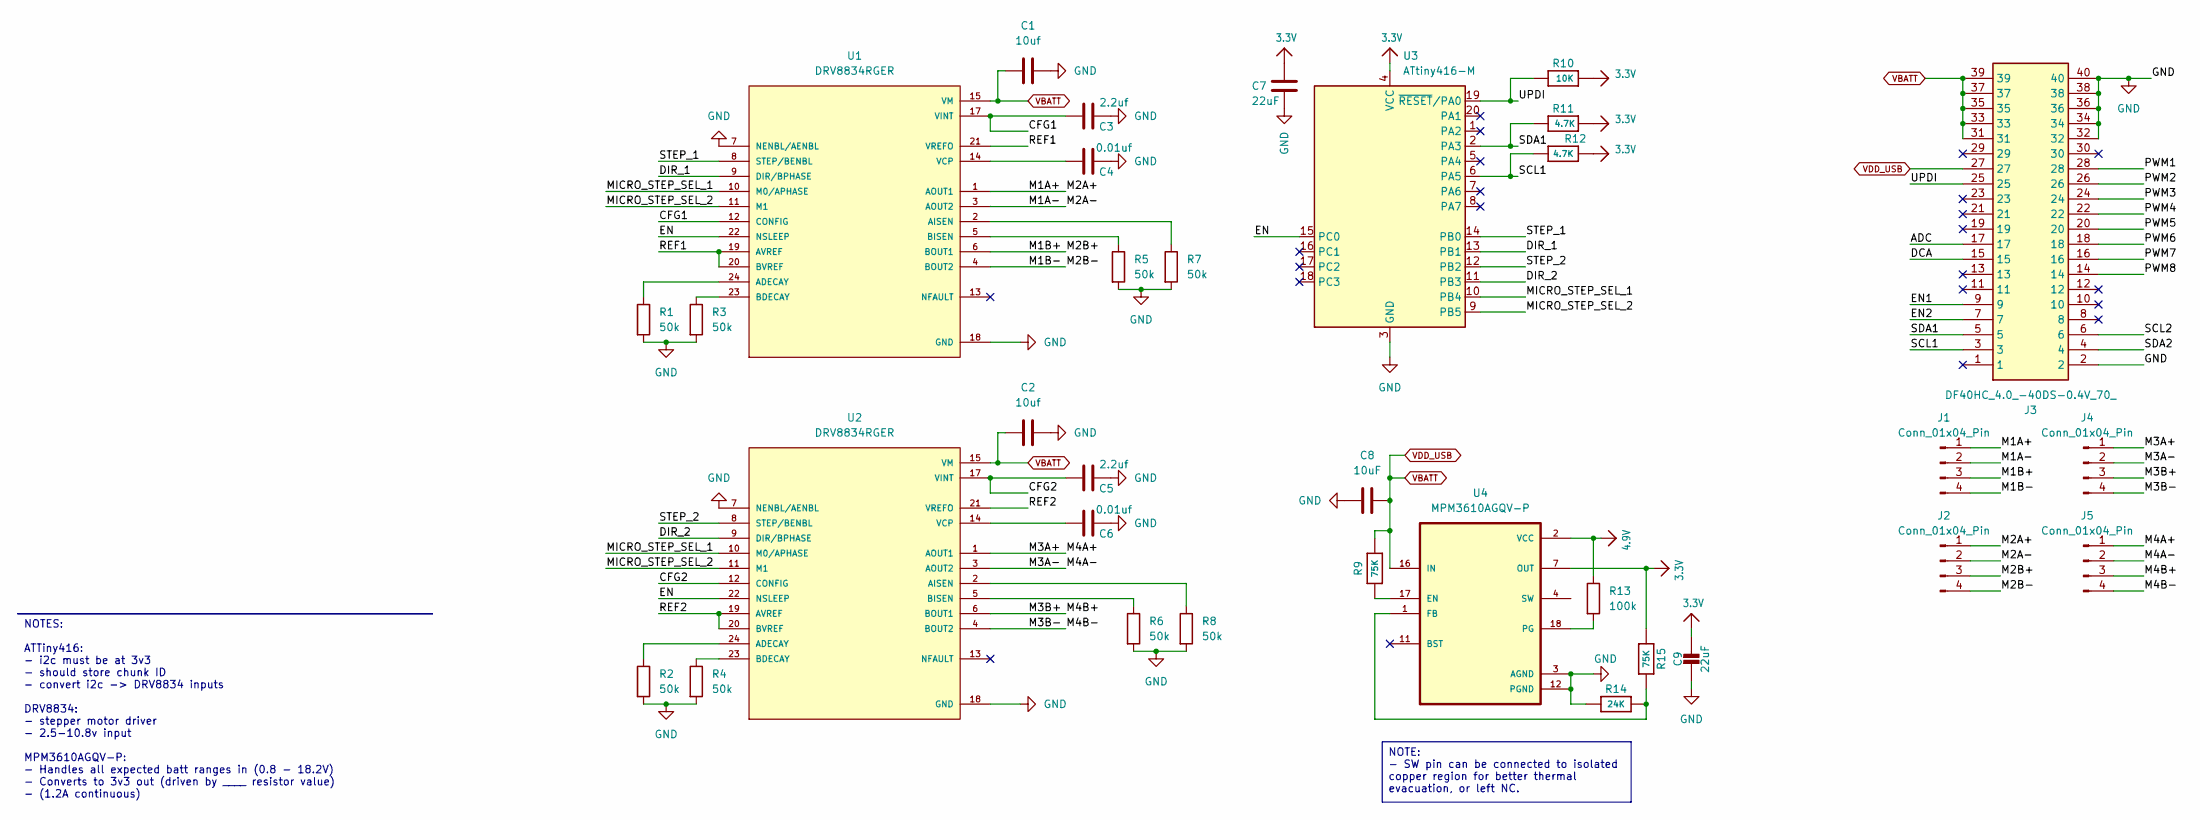
[picture p23: schematic Wheel_chunk.kicad_sch]

Parts:
C1, C2: 10uf; C_0805_2012Metric
C3, C5: 2.2uf; C_0805_2012Metric
C4, C6: 0.01uf; C_0805_2012Metric
C7, C9: 22uF; C_0805_2012Metric
C8: 10uF; C_0805_2012Metric
J1, J2, J4, J5: Conn_01x04_Pin; PAD_1x4_4.0x2.0
J3: DF40HC_4.0_-40DS-0.4V_70_; DF40HC4040DS04V70; Mouser Part Number 798-DF4HC4040DS04V70
R1, R2, R3, R4, R5, R6, R7, R8: 50k; R_0805_2012Metric
R9, R15: 75K; R_0805_2012Metric
R10: 10K; R_0805_2012Metric
R11, R12: 4.7K; R_0805_2012Metric
R13: 100k; R_0805_2012Metric
R14: 24K; R_0805_2012Metric
U1, U2: DRV8834RGER; DRIVER_DRV8834RGER; PARTREV D
U3: ATtiny416-M; VQFN-20-1EP_3x3mm_P0.4mm_EP1.7x1.7mm
U4: MPM3610AGQV-P; CONV_MPM3620AGQV-P; PARTREV 1.0

Connections:
3.3V: C7.2, C9.1, R10.2, R11.2, R12.2, R15.1, U3.4 (VCC), U4.7 (OUT), U4.8 (OUT), U4.9 (OUT), U4.20 (OUT)
4.9V: R13.1, U4.2 (VCC)
/ADC: J3.17
/CFG1: C3.1, U1.12 (CONFIG), U1.17 (VINT)
/CFG2: C5.1, U2.12 (CONFIG), U2.17 (VINT)
/DCA: J3.15
/DIR_1: U1.9 (DIR/BPHASE), U3.13 (PB1)
/DIR_2: U2.9 (DIR/BPHASE), U3.11 (PB3)
/EN: U1.22 (NSLEEP), U2.22 (NSLEEP), U3.15 (PC0)
/EN1: J3.9
/EN2: J3.7
/M1A+: J1.1, J2.1, U1.1 (AOUT1)
/M1A-: J1.2, J2.2, U1.3 (AOUT2)
/M1B+: J1.3, J2.3, U1.6 (BOUT1)
/M1B-: J1.4, J2.4, U1.4 (BOUT2)
/M3A+: J4.1, J5.1, U2.1 (AOUT1)
/M3A-: J4.2, J5.2, U2.3 (AOUT2)
/M3B+: J4.3, J5.3, U2.6 (BOUT1)
/M3B-: J4.4, J5.4, U2.4 (BOUT2)
/MICRO_STEP_SEL_1: U1.10 (M0/APHASE), U2.10 (M0/APHASE), U3.10 (PB4)
/MICRO_STEP_SEL_2: U1.11 (M1), U2.11 (M1), U3.9 (PB5)
/PWM1: J3.28
/PWM2: J3.26
/PWM3: J3.24
/PWM4: J3.22
/PWM5: J3.20
/PWM6: J3.18
/PWM7: J3.16
/PWM8: J3.14
/REF1: U1.19 (AVREF), U1.20 (BVREF), U1.21 (VREFO)
/REF2: U2.19 (AVREF), U2.20 (BVREF), U2.21 (VREFO)
/SCL1: J3.3, R12.1, U3.6 (PA5)
/SCL2: J3.6
/SDA1: J3.5, R11.1, U3.2 (PA3)
/SDA2: J3.4
/STEP_1: U1.8 (STEP/BENBL), U3.14 (PB0)
/STEP_2: U2.8 (STEP/BENBL), U3.12 (PB2)
/UPDI: J3.25, R10.1, U3.19 (~RESET/PA0)
GND: C1.2, C2.2, C3.2, C4.2, C5.2, C6.2, C7.1, C8.1, C9.2, J3.2, J3.32, J3.34, J3.36, J3.38, J3.40, R1.2, R2.2, R3.2, R4.2, R5.2, R6.2, R7.2, R8.2, R14.1, U1.7 (NENBL/AENBL), U1.18 (GND), U1.25 (GND), U1.25.1 (GND), U1.25.2 (GND), U1.25.3 (GND), U1.25.4 (GND), U1.25.5 (GND), U2.7 (NENBL/AENBL), U2.18 (GND), U2.25 (GND), U2.25.1 (GND), U2.25.2 (GND), U2.25.3 (GND), U2.25.4 (GND), U2.25.5 (GND), U3.3 (GND), U3.21 (GND), U4.3 (AGND), U4.12 (PGND), U4.13 (PGND), U4.14 (PGND)
unnamed: R1.1, U1.24 (ADECAY)
unnamed: R7.1, U1.2 (AISEN)
unnamed: R3.1, U1.23 (BDECAY)
unnamed: R5.1, U1.5 (BISEN)
unnamed: C4.1, U1.14 (VCP)
unnamed: R2.1, U2.24 (ADECAY)
unnamed: R8.1, U2.2 (AISEN)
unnamed: R4.1, U2.23 (BDECAY)
unnamed: R6.1, U2.5 (BISEN)
unnamed: C6.1, U2.14 (VCP)
unnamed: R9.2, U4.17 (EN)
unnamed: R14.2, R15.2, U4.1 (FB)
unnamed: R13.2, U4.18 (PG)
unnamed: U4.4 (SW), U4.5 (SW), U4.6 (SW), U4.19 (SW)
VBATT: C1.1, C2.1, C8.2, J3.27, J3.31, J3.33, J3.35, J3.37, J3.39, R9.1, U1.15 (VM), U1.16 (VM), U2.15 (VM), U2.16 (VM), U4.16 (IN)

Notes on the sheet:
NOTE: - SW pin can be connected to isolated copper region for better thermal evacuation, or left NC.
NOTES: ATTiny416: - i2c must be at 3v3 - should store chunk ID - convert i2c -> DRV8834 inputs DRV8834: - stepper motor driver - 2.5-10.8v input MPM3610AGQV-P: - Handles all expected batt ranges in (0.8 - 18.2V) - Converts to 3v3 out (driven by ____ resistor value) - (1.2A continuous)

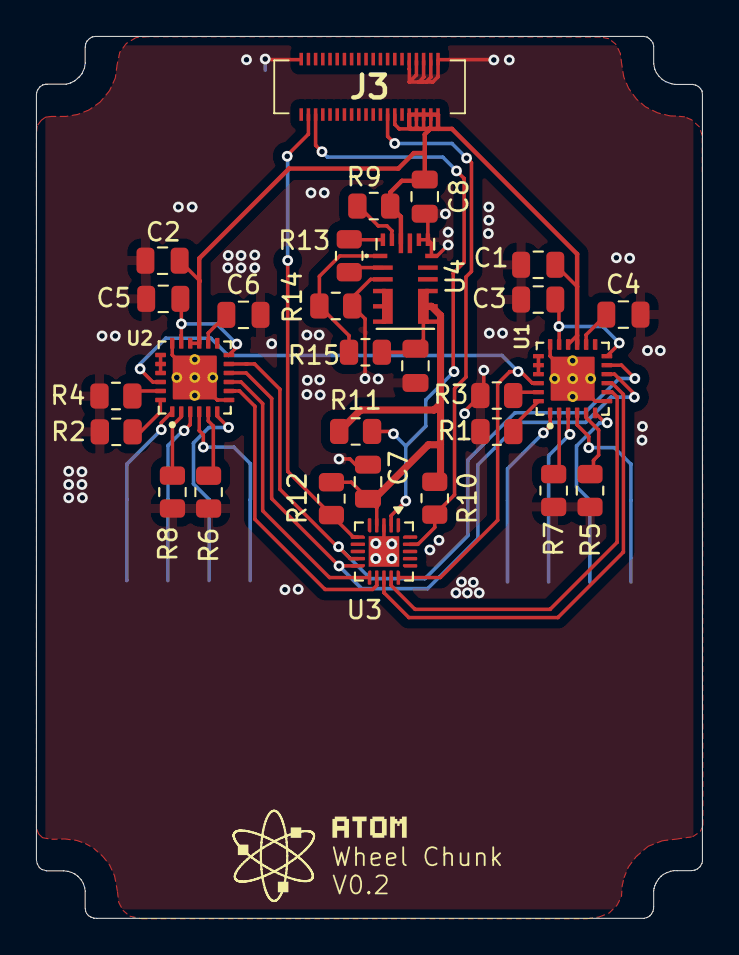
[picture p24: board Wheel_chunk.kicad_pcb from above]

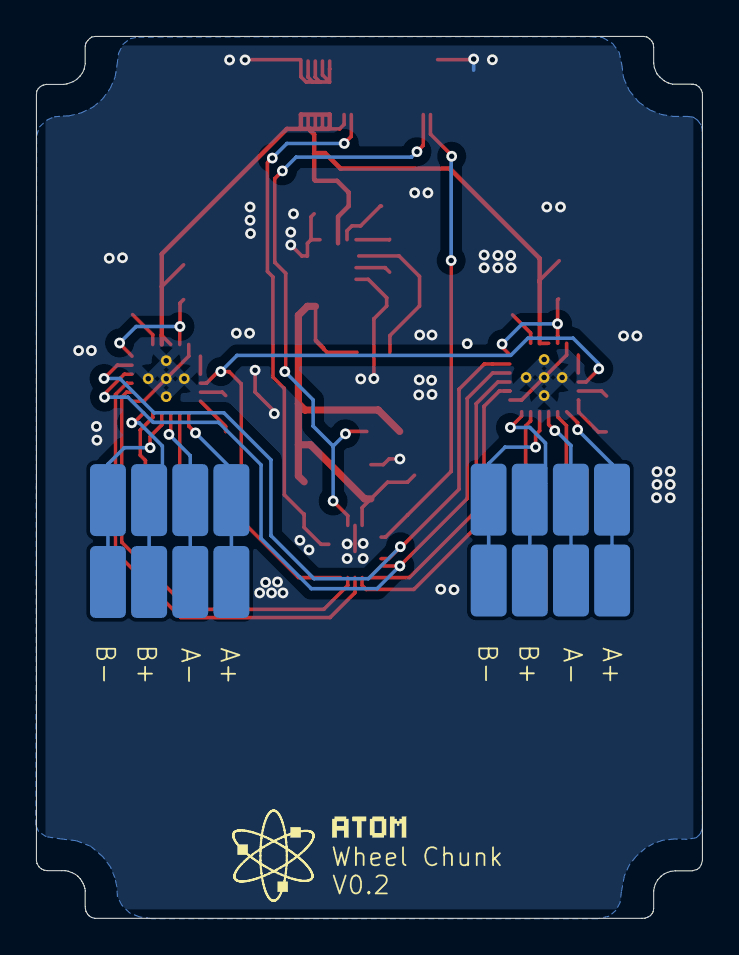
[picture p25: board Wheel_chunk.kicad_pcb from below]

Board: 2 copper layers, 37.0 x 49.0 mm, 33 parts (4 on the bottom side), 39 nets.
