paul-jo-dreyer/Atom/AtomPCB/chunks/Compute_chunk/Compute_chunk.kicad_pcb

## KiCad design AtomPCB/chunks/Compute_chunk/Compute_chunk.kicad_pcb (2026-05-16)

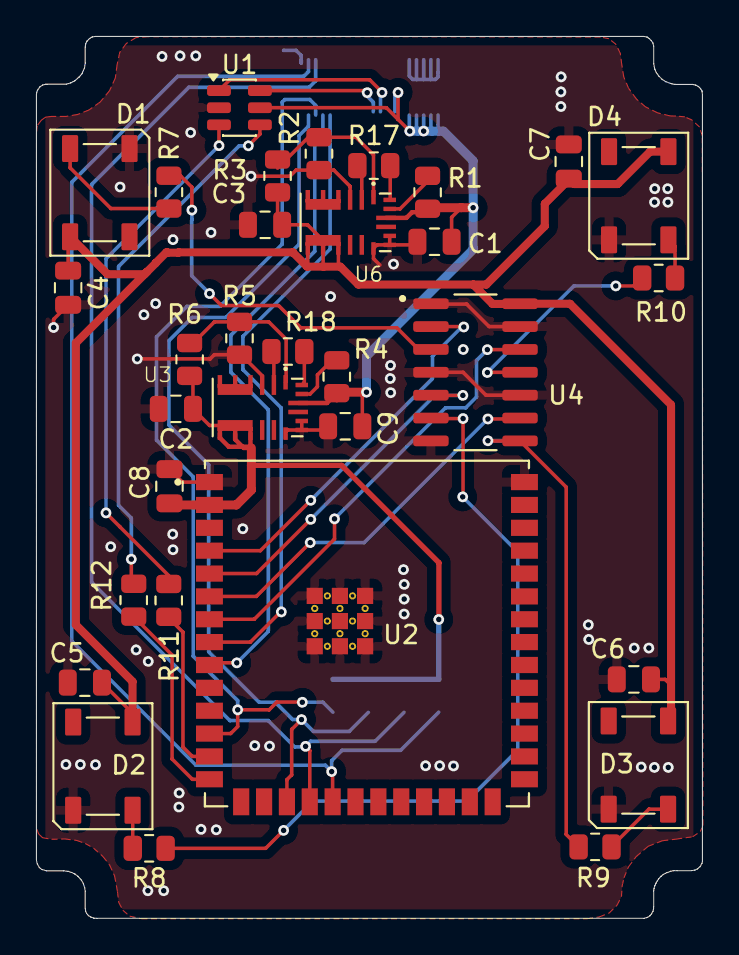
[picture p26: board Compute_chunk.kicad_pcb from above]

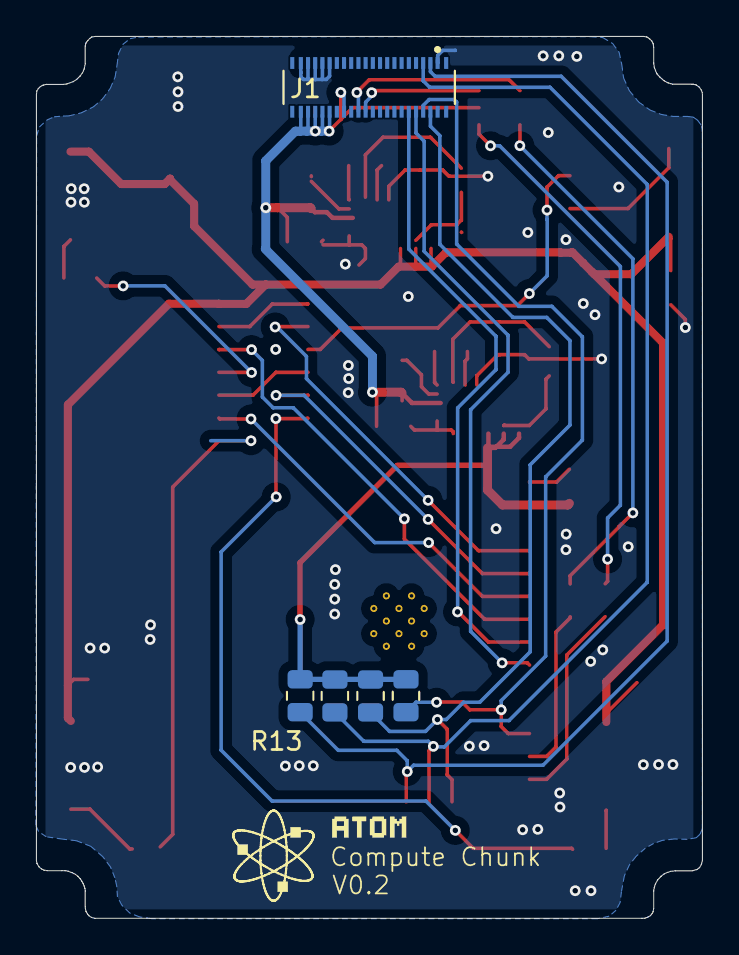
[picture p27: board Compute_chunk.kicad_pcb from below]

Board: 2 copper layers, 37.0 x 49.0 mm, 37 parts (5 on the bottom side), 35 nets.

Parts:
C1, C9: 10uF; C_0805_2012Metric
C2, C3, C8: 22uF; C_0805_2012Metric
C4, C5, C6, C7: 0.1uF; C_0805_2012Metric
D1, D2, D3, D4: WS2812B; LED_WS2812B_PLCC4_5.0x5.0mm_P3.2mm
J1: DF40C-40DP-0.4V_51_; HRS_DF40C-40DP-0.4V_51_
R1, R4, R6: 75K; R_0805_2012Metric
R2: 19.1k; R_0805_2012Metric
R3, R17, R18: 100k; R_0805_2012Metric
R5: 24K; R_0805_2012Metric
R7, R8, R9, R10: 300; R_0805_2012Metric
R11, R12: 22; R_0805_2012Metric
R13, R14, R15, R16: 4.7K; R_0805_2012Metric
U1: USBLC6-2SC6; SOT-23-6
U2: ESP32-S3-WROOM-1U-N8R8; XCVR_ESP32-S3-WROOM-1U-N8R8
U3, U6: MPM3610AGQV-P; CONV_MPM3620AGQV-P
U4: SN74HCT125DR; SOIC127P600X175-14N

Connections:
3.3V: C2.1, C8.2, R6.1, R13.1, R14.2, R15.1, R16.1, U2.2 (3V3), U3.7 (OUT)
4.9V: R17.1, R18.1, U3.2 (VCC), U6.2 (VCC)
5.0V: C3.1, C4.2, C5.2, C6.2, C7.2, D1.1 (VDD), D2.1 (VDD), D3.1 (VDD), D4.1 (VDD), R3.1, U4.14 (VCC), U6.7 (OUT)
/DATA_D+: R12.2, U1.4 (I/O2)
/DATA_D-: R11.2, U1.3 (I/O2)
/EN1: J1.10, U2.8 (IO15)
/EN2: J1.8, U2.9 (IO16)
/LED1_CH: R7.1, U4.3 (1Y)
/LED1_CL: U2.4 (IO4), U4.2 (1A)
/LED2_CH: R8.1, U4.6 (2Y)
/LED2_CL: U2.5 (IO5), U4.5 (2A)
/LED3_CH: R9.1, U4.8 (3Y)
/LED3_CL: U2.6 (IO6), U4.9 (3A)
/LED4_CH: R10.1, U4.11 (4Y)
/LED4_CL: U2.7 (IO7), U4.12 (4A)
/SCL1: J1.4, R14.1, U2.17 (IO9)
/SCL2: J1.5, R15.2, U2.18 (IO10)
/SDA1: J1.6, R13.2, U2.12 (IO8)
/SDA2: J1.3, R16.2, U2.19 (IO11)
GND: C1.1, C2.2, C3.2, C4.1, C5.1, C6.1, C7.1, C8.1, C9.1, D1.3 (VSS), D2.3 (VSS), D3.3 (VSS), D4.3 (VSS), J1.1, J1.31, J1.33, J1.35, J1.37, J1.39, R2.1, R5.1, U1.2 (GND), U2.1 (GND), U2.40 (GND__1), U2.41_1 (GND__2), U2.41_2 (GND__3), U2.41_3 (GND__4), U2.41_4 (GND__5), U2.41_5 (GND__6), U2.41_6 (GND__7), U2.41_7 (GND__8), U2.41_8 (GND__9), U2.41_9 (GND__10), U3.3 (AGND), U3.12 (PGND), U3.13 (PGND), U3.14 (PGND), U4.1 (1~OE), U4.4 (2~OE), U4.7 (GND), U4.10 (3~OE), U4.13 (4~OE), U6.3 (AGND), U6.12 (PGND), U6.13 (PGND), U6.14 (PGND)
unnamed: D1.4 (DIN), R7.2
unnamed: D2.4 (DIN), R8.2
unnamed: D3.4 (DIN), R9.2
unnamed: D4.4 (DIN), R10.2
unnamed: J1.22, U1.6 (I/O1)
unnamed: J1.24, U1.1 (I/O1)
unnamed: R11.1, U2.13 (IO19)
unnamed: R12.1, U2.14 (IO20)
unnamed: R4.2, U3.17 (EN)
unnamed: R5.2, R6.2, U3.1 (FB)
unnamed: R18.2, U3.18 (PG)
unnamed: R1.2, U6.17 (EN)
unnamed: R2.2, R3.2, U6.1 (FB)
unnamed: R17.2, U6.18 (PG)
VBATT: C1.2, C9.2, J1.28, J1.32, J1.34, J1.36, J1.38, J1.40, R1.1, R4.1, U1.5 (VBUS), U3.16 (IN), U6.16 (IN)
