paul-jo-dreyer/Atom/AtomPCB/chunks/Battery_chunk/lower_board/battery_chunk_lower_board.kicad_pcb

## KiCad design AtomPCB/chunks/Battery_chunk/lower_board/battery_chunk_lower_board.kicad_pcb (2026-04-27)

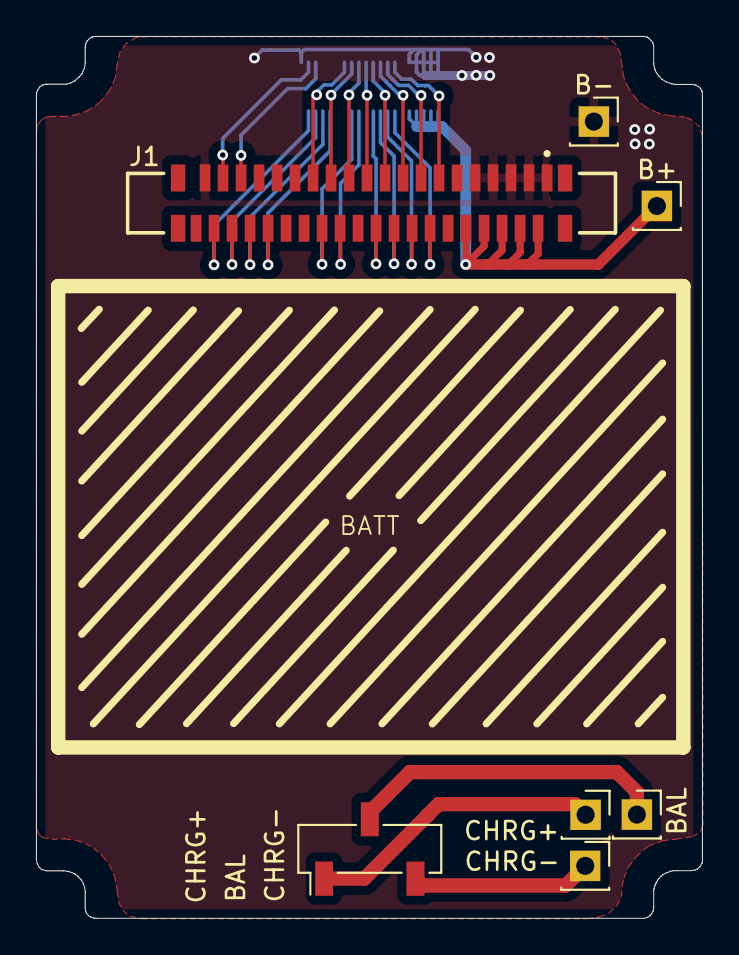
[picture p28: board battery_chunk_lower_board.kicad_pcb from above]

Board: 2 copper layers, 37.0 x 49.0 mm, 8 parts (1 on the bottom side), 25 nets.

Parts:
B+: Conn_01x01_Pin; PinSocket_1x01_P2.54mm_Vertical
B-: Conn_01x01_Pin; PinSocket_1x01_P2.54mm_Vertical
BAL: Conn_01x01_Pin; PinSocket_1x01_P2.54mm_Vertical
CHRG+: Conn_01x01_Pin; PinSocket_1x01_P2.54mm_Vertical
CHRG-: Conn_01x01_Pin; PinSocket_1x01_P2.54mm_Vertical
J1: Conn_02x20_Odd_Even; GCT_FFC2A32-40-T
J7: DF40C-40DP-0.4V_51_; HRS_DF40C-40DP-0.4V_51_
J10: Conn_01x03_Pin; PinSocket_1x03_P2.54mm_Vertical_SMD_Pin1Left

Connections:
/Battery_chunk_lower/ADC: J1.24, J7.23
/Battery_chunk_lower/CHRG_+: CHRG+.1, J10.1
/Battery_chunk_lower/CHRG_-: CHRG-.1, J10.3
/Battery_chunk_lower/CHRG_BAL: BAL.1, J10.2
/Battery_chunk_lower/DATA_D+: J1.20, J7.19
/Battery_chunk_lower/DATA_D-: J1.18, J7.17
/Battery_chunk_lower/DCA: J1.26, J7.25
/Battery_chunk_lower/EN1: J1.32, J7.31
/Battery_chunk_lower/EN2: J1.34, J7.33
/Battery_chunk_lower/PWM1: J1.13, J7.14
/Battery_chunk_lower/PWM2: J1.15, J7.16
/Battery_chunk_lower/PWM3: J1.17, J7.18
/Battery_chunk_lower/PWM4: J1.19, J7.20
/Battery_chunk_lower/PWM5: J1.21, J7.22
/Battery_chunk_lower/PWM6: J1.23, J7.24
/Battery_chunk_lower/PWM7: J1.25, J7.26
/Battery_chunk_lower/PWM8: J1.27, J7.28
/Battery_chunk_lower/SCL1: J1.38, J7.37
/Battery_chunk_lower/SCL2: J1.35, J7.36
/Battery_chunk_lower/SDA1: J1.36, J7.35
/Battery_chunk_lower/SDA2: J1.37, J7.38
/Battery_chunk_lower/UDPI: J1.16, J7.15
GND: B-.1, J1.1, J1.3, J1.5, J1.7, J1.9, J1.39, J7.2, J7.4, J7.6, J7.8, J7.10, J7.40
VBATT: B+.1, J1.2, J1.4, J1.6, J1.8, J1.10, J7.1, J7.3, J7.5, J7.7, J7.9
VDD_USB: J1.14, J7.13
