paul-jo-dreyer/Atom/AtomPCB/chunk_programmer/chunk_programmer.kicad_pcb

## KiCad design AtomPCB/chunk_programmer/chunk_programmer.kicad_pcb (2026-04-27)

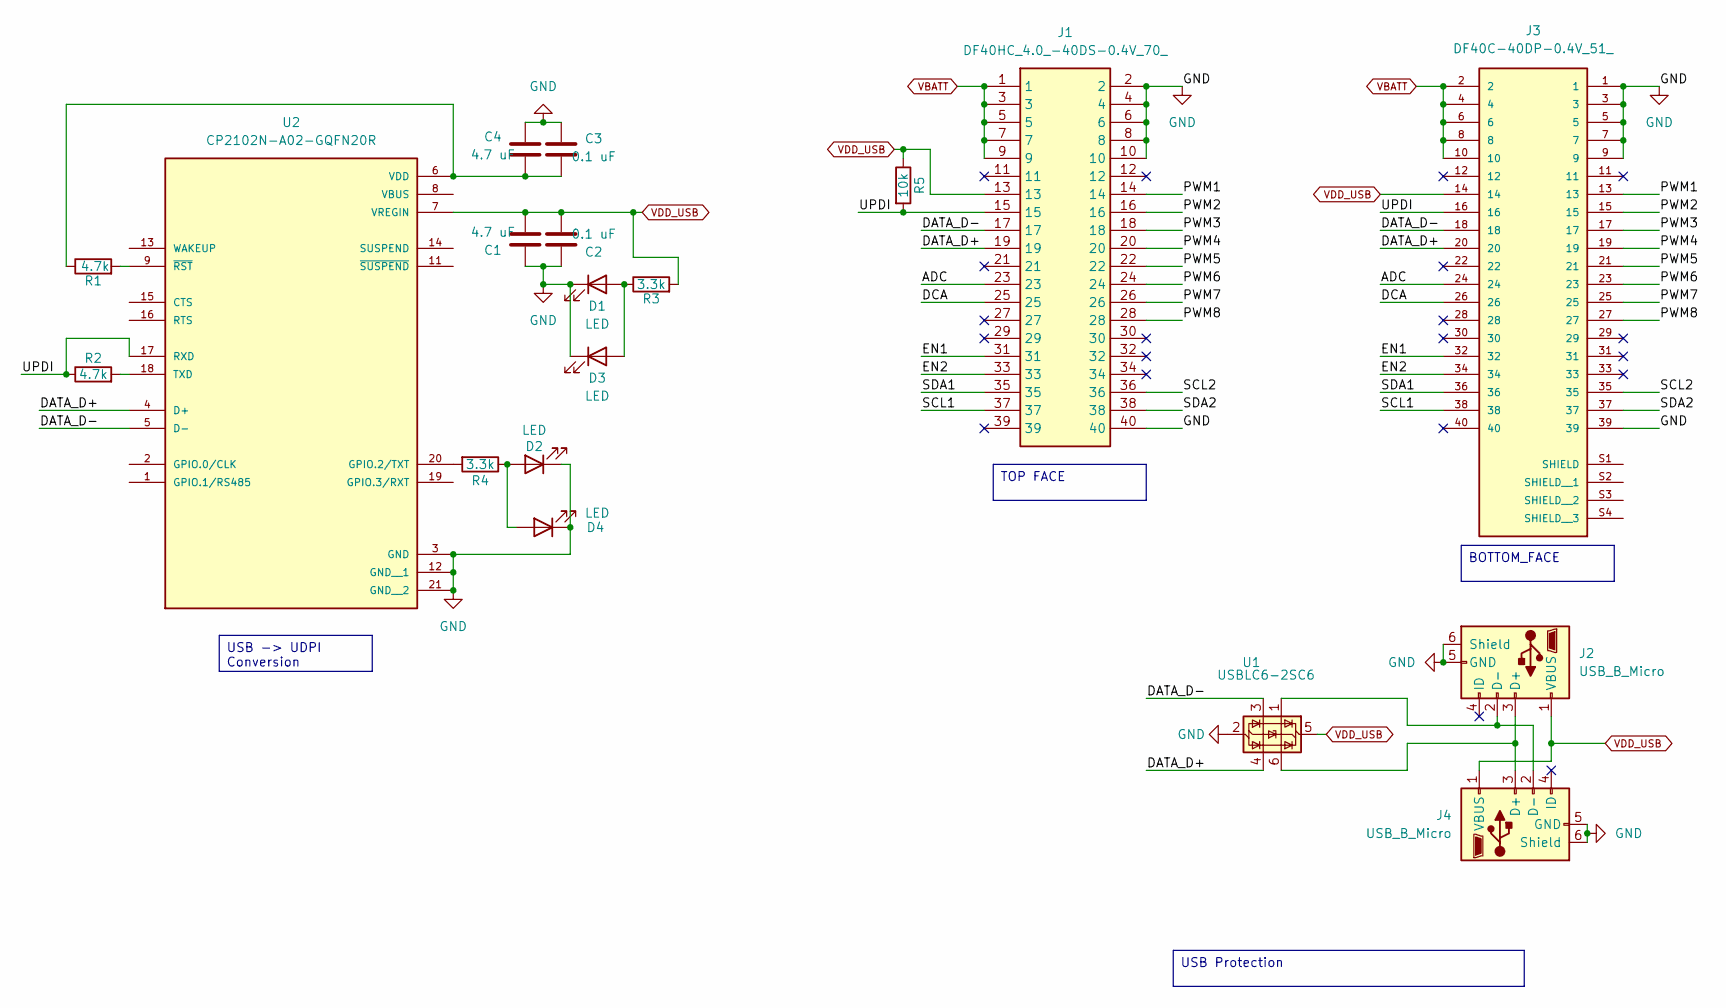
[picture p29: schematic chunk_programmer.kicad_sch]

Parts:
C1, C4: 4.7 uF; C_0805_2012Metric
C2, C3: 0.1 uF; C_0805_2012Metric
D1, D2, D3, D4: LED; LED_0603_1608Metric
J1: DF40HC_4.0_-40DS-0.4V_70_; DF40HC4040DS04V70; Mouser Part Number 798-DF4HC4040DS04V70
J2, J4: USB_B_Micro; USB_Micro-B_Amphenol_10118194_Horizontal
J3: DF40C-40DP-0.4V_51_; HRS_DF40C-40DP-0.4V_51_
R1, R2: 4.7k; R_0805_2012Metric
R3, R4: 3.3k; R_0805_2012Metric
R5: 10k; R_0805_2012Metric
U1: USBLC6-2SC6; SOT-23-6
U2: CP2102N-A02-GQFN20R; SILABS_CP2102N-A02-GQFN20R; PARTREV 1.3

Connections:
/ADC: J1.23, J3.24
/DATA_D+: J1.19, J3.20, U1.4 (I/O2), U2.4 (D+)
/DATA_D-: J1.17, J3.18, U1.3 (I/O2), U2.5 (D-)
/DCA: J1.25, J3.26
/EN1: J1.31, J3.32
/EN2: J1.33, J3.34
/PWM1: J1.14, J3.13
/PWM2: J1.16, J3.15
/PWM3: J1.18, J3.17
/PWM4: J1.20, J3.19
/PWM5: J1.22, J3.21
/PWM6: J1.24, J3.23
/PWM7: J1.26, J3.25
/PWM8: J1.28, J3.27
/SCL1: J1.37, J3.38
/SCL2: J1.36, J3.35
/SDA1: J1.35, J3.36
/SDA2: J1.38, J3.37
/UPDI: J1.15, J3.16, R2.1, R5.2, U2.17 (RXD)
GND: C1.1, C2.1, C3.1, C4.1, D1.1 (K), D2.1 (K), D3.1 (K), D4.1 (K), J1.2, J1.4, J1.6, J1.8, J1.10, J1.40, J2.5 (GND), J2.6 (Shield), J3.1, J3.3, J3.5, J3.7, J3.9, J3.39, J4.5 (GND), J4.6 (Shield), U1.2 (GND), U2.3 (GND), U2.12 (GND__1), U2.21 (GND__2)
unnamed: D1.2 (A), D3.2 (A), R3.1
unnamed: D2.2 (A), D4.2 (A), R4.1
unnamed: J2.3 (D+), J4.3 (D+), U1.6 (I/O1)
unnamed: J2.2 (D-), J4.2 (D-), U1.1 (I/O1)
unnamed: R4.2, U2.20 (GPIO.2/TXT)
unnamed: R2.2, U2.18 (TXD)
unnamed: C3.2, C4.2, R1.1, U2.6 (VDD)
unnamed: R1.2, U2.9 (~RST)
VBATT: J1.1, J1.3, J1.5, J1.7, J1.9, J3.2, J3.4, J3.6, J3.8, J3.10
VDD_USB: C1.2, C2.2, J1.13, J2.1 (VBUS), J3.14, J4.1 (VBUS), R3.2, R5.1, U1.5 (VBUS), U2.7 (VREGIN)

Notes on the sheet:
BOTTOM_FACE
USB Protection
USB -> UDPI Conversion
TOP FACE

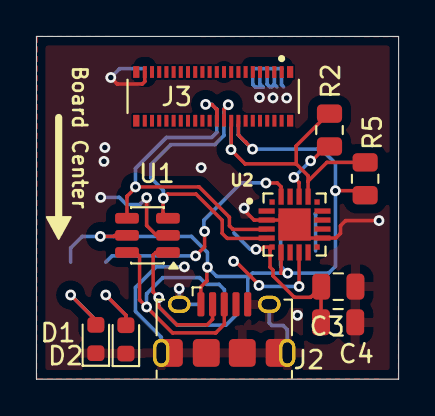
[picture p30: board chunk_programmer.kicad_pcb from above]

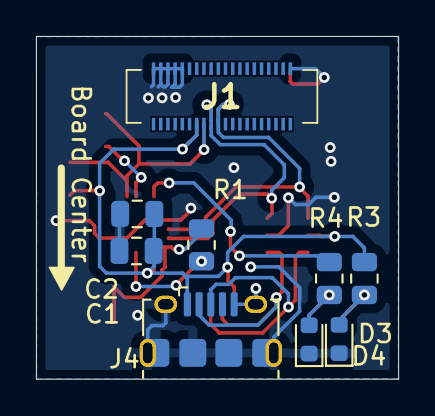
[picture p31: board chunk_programmer.kicad_pcb from below]

Board: 2 copper layers, 20.1 x 19.0 mm, 19 parts (9 on the bottom side), 30 nets.
