paul-jo-dreyer/Atom/AtomSim/sim/configs/styles/default.yaml

# AtomSim renderer style — colors, shapes, resolution.
#
# Colors are "#RRGGBB" hex strings. Resolutions are [width, height] in pixels.
# Lengths in metres unless otherwise stated.
#
# This file is the default style for live teleop and headless export. Copy
# and tweak it (e.g. configs/styles/analysis.yaml for points-on-a-grid).

resolution:
  render: [1280, 720]      # internal raster size — what the renderer actually draws to
  output: [1280, 720]      # output size (live: window size; headless: video frame size)
  # Note: keep both width and height divisible by 16 for clean H.264 mp4 encoding.

field:
  background: "#FFFFFF"
  field_color: "#2E7D32" # turf green; extends past the field bounds into the walls and goal chambers
                           # render surface (beyond the white border lines)
  walls: "#FFFFFF"         # white field-perimeter + goal-chamber lines
  walls_width_px: 3
  # Mowed-grass overlay: alternating-brightness bands on top of the base
  # turf. Set `mowed_stripes_n: 0` to disable for a flat turf.
  mowed_stripes_n: 12          # number of stripes across the turf
  mowed_stripes_delta: 14      # ±RGB shift between adjacent stripes
  mowed_stripes_axis: vertical # vertical | horizontal
  # Per-side goal-chamber colours (frame + net). Blue defends the
  # LEFT goal, orange defends the RIGHT. Set to null for plain white.
  goal_color_left: "#3B82F6"   # blue body_color
  goal_color_right: "#F97316"  # orange body_color

# Cosmetic interior field markings — center circle, halfway line, and goalie
# (penalty) boxes. Drawn purely on the visual layer, no physics interaction.
markings:
  enabled: true
  color: "#FFFFFF"
  line_width_px: 3
  center_circle_radius_m: 0.1     # ~scaled penalty arc / centre circle
  halfway_line: true               # vertical line through x = 0
  goalie_box_depth_m: 0.13         # distance the box extends INTO the field
  goalie_box_height_m: 0.22        # full vertical extent (top to bottom)
  goalie_box_corner_radius_m: 0.07 # radius of the rounded interior corners (0 = sharp)
  # Per-side goalie-box colours — sourced from team palette below.
  # Convention: blue defends the LEFT goal (-x), orange defends the
  # RIGHT goal (+x). Set to null to use the default white markings.
  box_color_left: "#3B82F6"        # blue body_color
  box_color_right: "#F97316"       # orange body_color
  box_fill_alpha: 65               # 0 = outline only; 40-80 = subtle team-tint fill

# Default style for any robot whose `team` key is null or unknown.
# Per-team overrides go under `teams:` below.
robot:
  shape: full              # full | square_only | point
  body_color: "#A5B4E6"
  manipulator_color: "#EBA55A"
  body_outline_color: "#282859"
  manipulator_outline_color: "#8C5523"
  show_axes: true          # red x-axis (forward) + green y-axis (left), drawn from body origin
  axes_length_m: 0.025
  axes_width_px: 3
  point_radius_px: 6       # circle radius when shape == "point"

ball:
  shape: circle            # circle | point
  color: "#DC4646"
  outline_color: "#8C2323"
  point_radius_px: 4

# Per-team color overrides. A robot whose `team` field matches one of these
# keys uses these colors instead of the defaults above. All four override
# fields are optional — omit a field to inherit the default.
teams:
  blue:
    body_color: "#3B82F6"
    manipulator_color: "#1E40AF"
    body_outline_color: "#1E3A8A"
    manipulator_outline_color: "#0F2257"
  orange:
    body_color: "#F97316"
    manipulator_color: "#C2410C"
    body_outline_color: "#7C2D12"
    manipulator_outline_color: "#431407"

show_hud: true             # only honored by the live renderer
hud_color: "#000000"       # readable on the green field
