paul-jo-dreyer/Atom/(commit log)

2026-04-11 adding index tag id printing to display. added april tag pdf. modified ignore to add gradle files
2026-04-15 First wheel chunk pcb commit! Basic component sleection + schematic. whooho!
    [3v3_buck_template.kicad_sch, Adafruit MPM3610.sch, DF40HC4040DS04V70.PcbLib, DF40HC_4.0_-40DS-0.4V_70_.SchLib, DF40HC_4.0_-40DS-0.4V_70_.stp, DRV8834RGER.step, EDI2CAP.CFG, MPM3610AGQV-P.step]
2026-04-19 adding core pcb templates. Finished rev 0.1 of wheel chunk pcb
    [2_layer_chunk_template.kicad_pcb, Wheel_chunk.kicad_pcb, Wheel_chunk.kicad_sch, Wheel_chunk_bu01.kicad_sch, bottom_chunk_template.kicad_pcb, chunk_template.kicad_pcb, templates.kicad_pcb, templates.kicad_sch]
2026-04-19 deleting old templatees
    [chunk_template.kicad_pcb, templates.kicad_pcb, templates.kicad_sch]
2026-04-20 initial pass on compute chunk completed.
    [Compute_chunk.kicad_pcb, Compute_chunk.kicad_sch, DF40C-40DP-0.4V_51_.step, ESP32-S3-WROOM-1U-N8R8.step, SN74HCT125DR.step, bottom_chunk_template.kicad_pcb, bottom_chunk_template.kicad_sch, templates.kicad_sch]
2026-04-27 first pcb panel order placed!
    [3v3_buck_template.kicad_sch, BF100-20-A-D-0-0640-L-C.STEP, Battery_chunk.kicad_sch, Battery_chunk_lower_board.kicad_sch, Battery_chunk_upper_board.kicad_pcb, Battery_chunk_upper_board.kicad_sch, Battery_chunk_upper_board.stl, CP2102N-A02-GQFN20R.step]
2026-04-27 initial c bindings and build tests
    [types.hpp]
2026-04-27 fixed bug with 'passthrough' manipulators
    [ball.cpp, ball.hpp, robot.cpp, types.hpp, world.cpp]
2026-04-28 enable multi robots in frame, add control input indicators to the header
2026-04-30 adding collisions to sim output. Adding sub proc sweeps to optimize through put
    [robot.cpp, robot.hpp]
2026-05-04 updating buck converter footprint to proper pin definitions
2026-05-04 updated compute chunk schematic to introduce missing resistor and capacitor. Changed diff resistor values on 3v3 buck
    [Compute_chunk.kicad_pcb, Compute_chunk.kicad_sch]
2026-05-10 improvments to device cards, + particle filter on feild frame estimation
2026-05-16 comput chunk updates, fixing buck converter issues
    [Compute_chunk.kicad_pcb]
2026-05-16 adding wheel chunk updates, fixing buck wiring issues
    [Wheel_chunk.kicad_pcb, Wheel_chunk.kicad_sch]
